TechanisYT/innoweek_amp/Neuer Ordner/2023-02-12 19_24_20-Negative voltage regulators - L7900_C.pdf – Mozilla Firefox.png

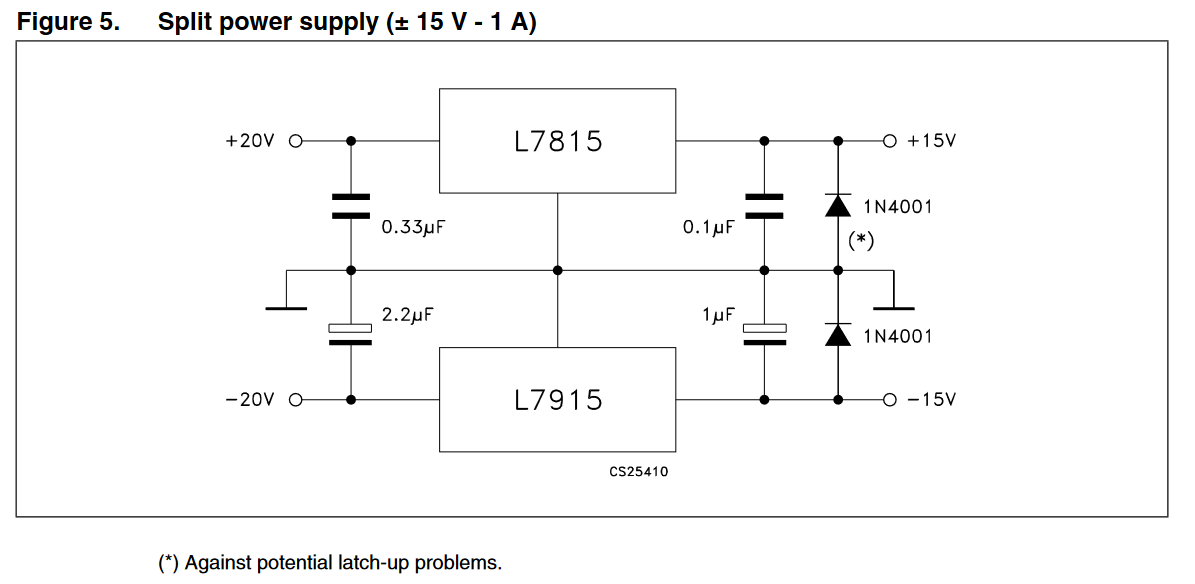
Neuer Ordner/2023-02-12 19_24_20-Negative voltage regulators - L7900_C.pdf – Mozilla Firefox.png
