TechanisYT/innoweek_amp/Steuerungs-Modul/v3.0/PCB.png

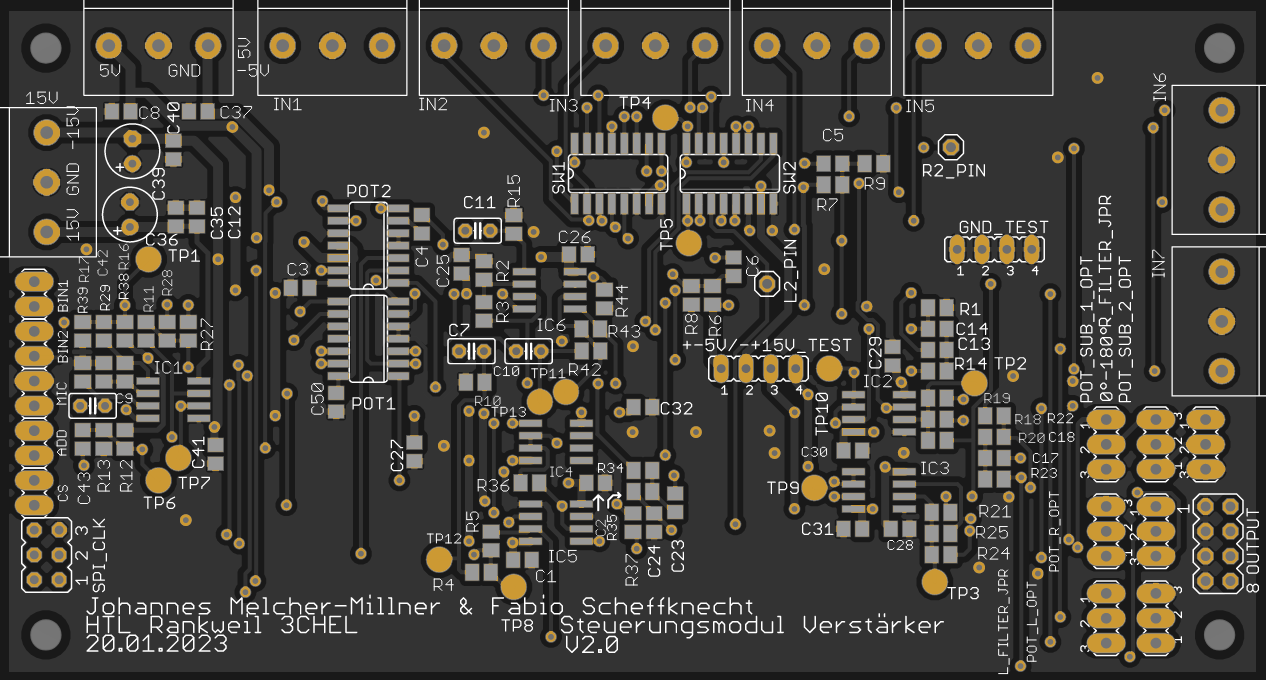
Steuerungs-Modul/v3.0/PCB.png
