TechanisYT/innoweek_amp/Steuerungs-Modul/v3.0/Steuerungsmodul.pdf

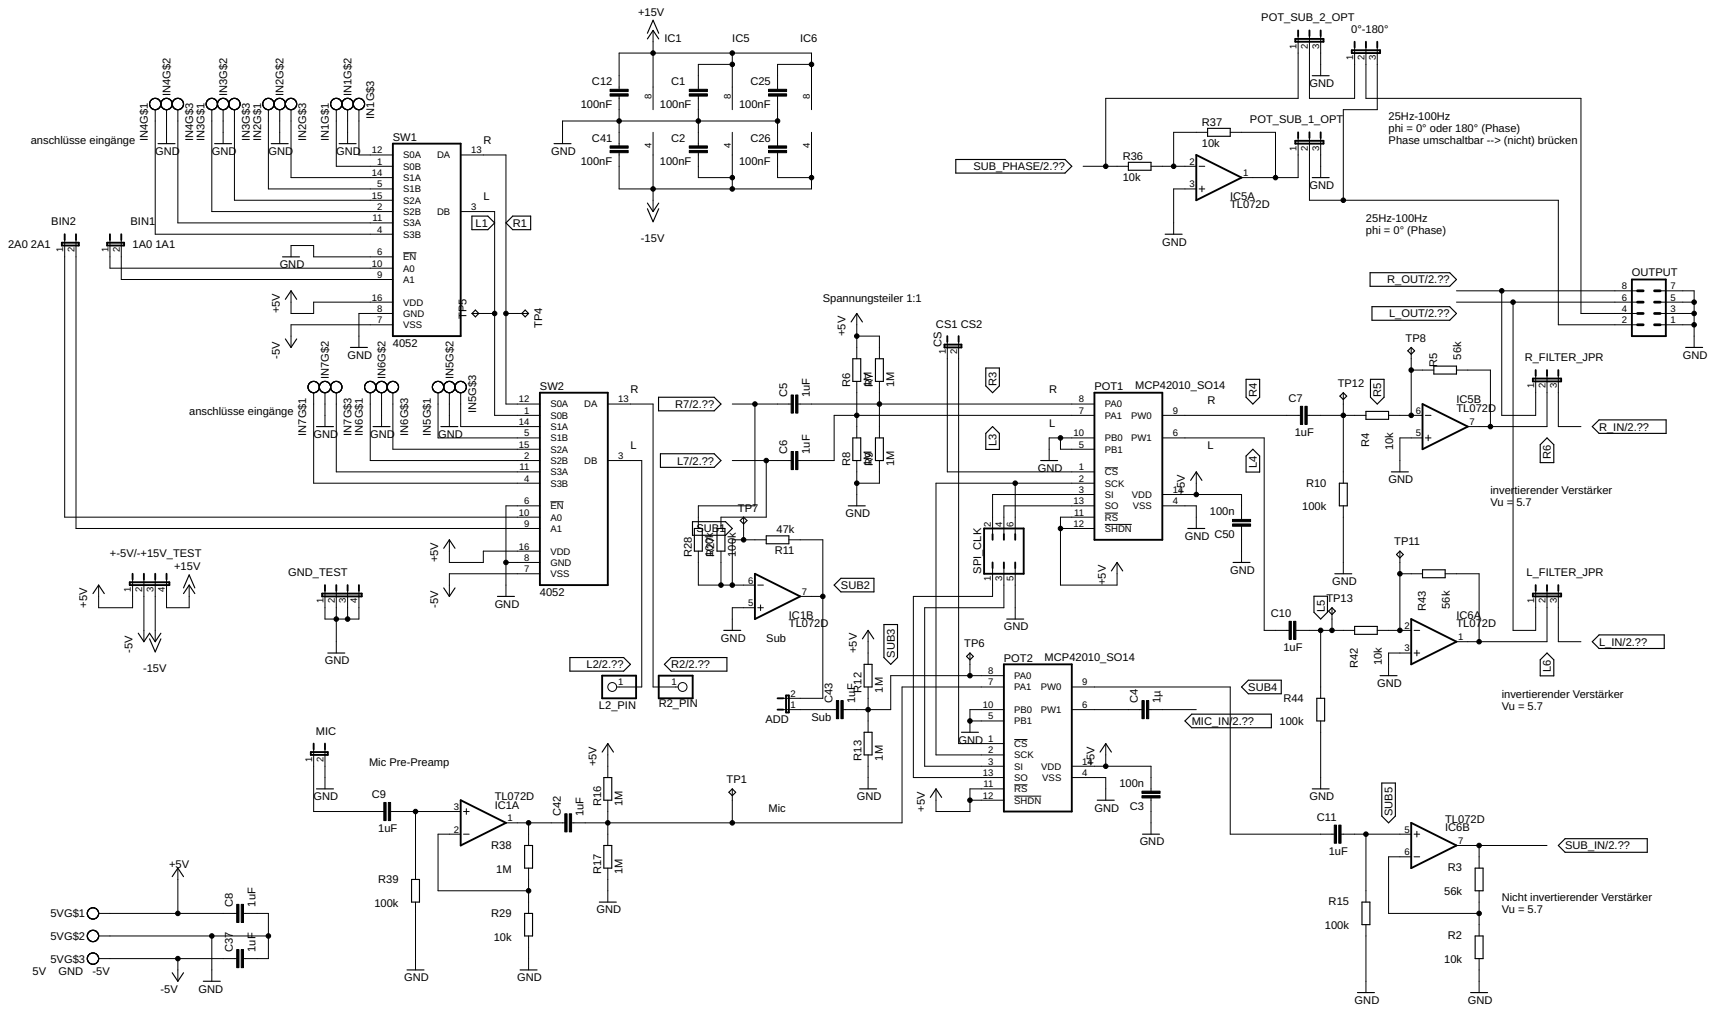
[picture p3: page 1]

25Hz-100Hz phi = 0° oder 180° (Phase)
Phase umschaltbar --> (nicht) brücken

Nicht invertierender Verstärker Vu = 5.7

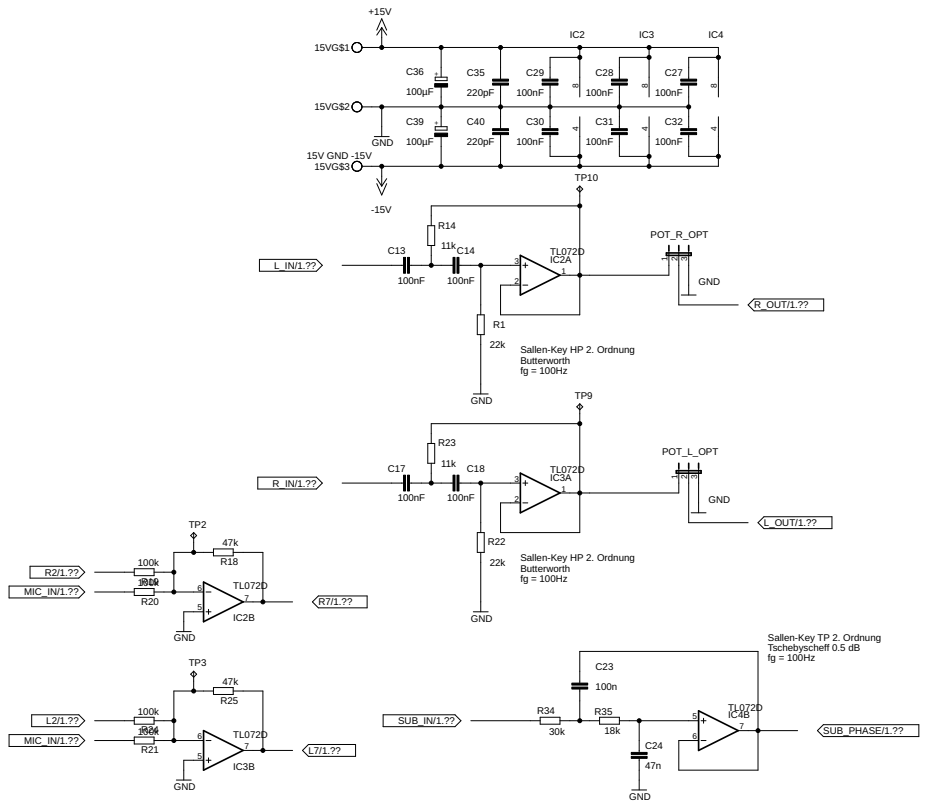
[picture p4: page 2]
