TechanisYT/innoweek_amp/Mono-Modul/Mono_Audio_Amplifier_Scheffknecht_Melcher.brd

## EAGLE design Mono-Modul/Mono_Audio_Amplifier_Scheffknecht_Melcher.brd (2023-11-27)

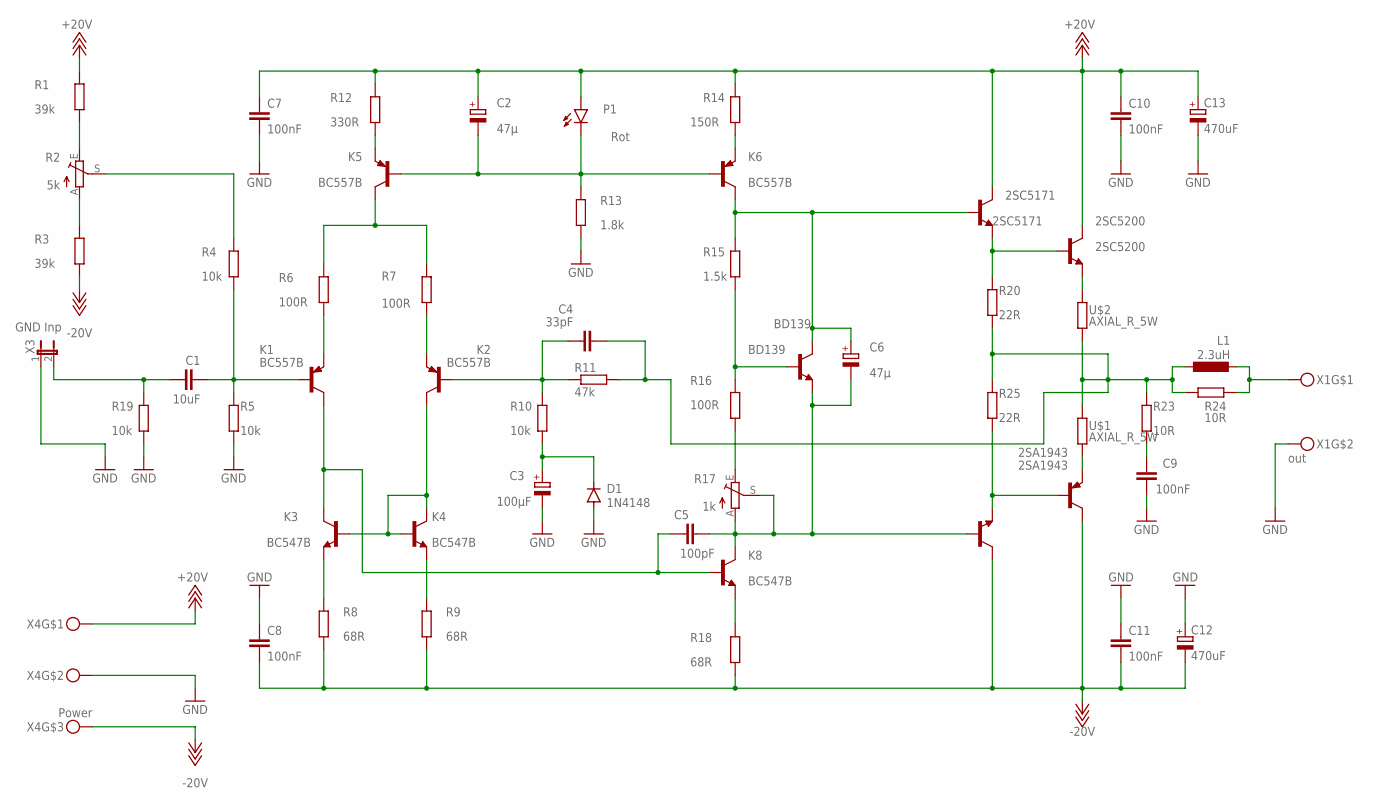
[picture p5: schematic Mono_Audio_Amplifier_Scheffknecht_Melcher.sch]

Parts:
2SA1930: 2SA1930; TO220BV
2SA1943: 2SA1943; TO264
2SC5171: 2SC5171; TO220BV
2SC5200: 2SC5200; TO264
BD139: BD139; TO126V
C1: 10uF; C0805
C2, C6: 47µ; E2,5-6
C3: 100µF; E2,5-7
C4: 33pF; C0805
C5: 100pF; C0805
C7, C8, C9, C10, C11: 100nF; C0805
C12, C13: 470uF; E3,5-8
D1: 1N4148; DO35-7
K1, K2, K5, K6: BC557B; TO92-EBC
K3, K4, K8: BC547B; TO92-CBE
L1: 2.3uH; TJ3-U2
P1: Rot; LED5MM
R1, R3: 39k; R0805
R2: 5k; S64W
R4, R5, R10, R19: 10k; R0805
R6, R7, R16: 100R; R0805
R8, R9, R18: 68R; R0805
R11: 47k; R0805
R12: 330R; R0805
R13: 1.8k; R0805
R14: 150R; R0805
R15: 1.5k; R0805
R17: 1k; S64W
R20, R25: 22R; R0805
R23, R24: 10R; R0805
U$1, U$2: AXIAL_R_5W; AXIAL_RESISTOR
X1: out; MKDS3/2_5,08
X3: GND Inp; JMP2
X4: Power; MKDS3/3_5,08

Connections:
+18V: 2SC5171.2 (C), 2SC5200.2 (C), C2.+, C7.1, C10.1, C13.+, P1.A, R1.1, R12.1, R14.1, X4.P$1
-18V: 2SA1930.2 (C), 2SA1943.2 (C), C8.2, C11.2, C12.-, R3.2, R8.2, R9.2, R18.2, X4.P$3
AUX_IN: C1.2, K1.B, R4.2, R5.1
GND: C3.-, C7.2, C8.1, C9.1, C10.2, C11.1, C12.+, C13.-, D1.A, R5.2, R13.2, R19.2, X1.P$2, X3.1, X4.P$2
unnamed: 2SC5200.3 (E), U$2.P$2 (2)
unnamed: 2SC5171.3 (E), 2SC5200.1 (B), R20.2
unnamed: 2SA1943.3 (E), U$1.P$1 (1)
unnamed: C4.2, L1.1, R11.2, R20.1, R23.2, R24.2, R25.2, U$1.P$2 (2), U$2.P$1 (1)
unnamed: C5.1, K1.C, K3.C, K8.B
unnamed: R16.2, R17.E
unnamed: BD139.3 (B), R15.2, R16.1
unnamed: 2SA1930.1 (B), BD139.1 (E), C5.2, C6.-, K8.C, R17.A, R17.S
unnamed: 2SC5171.1 (B), BD139.2 (C), C6.+, K6.C, R15.1
unnamed: K8.E, R18.1
unnamed: K6.E, R14.2
unnamed: K5.C, R6.1, R7.1
unnamed: K5.E, R12.2
unnamed: C4.1, K2.B, R10.1, R11.1
unnamed: K4.E, R9.1
unnamed: C2.-, K5.B, K6.B, P1.K (C), R13.1
unnamed: K1.E, R6.2
unnamed: K3.E, R8.1
unnamed: K2.E, R7.2
unnamed: K2.C, K3.B, K4.B, K4.C
unnamed: C3.+, D1.C, R10.2
unnamed: C9.2, R23.1
unnamed: C1.1, R19.1, X3.2
unnamed: R1.2, R2.E
unnamed: 2SA1930.3 (E), 2SA1943.1 (B), R25.1
unnamed: R2.S, R4.1
unnamed: R2.A, R3.1
unnamed: L1.2, R24.1, X1.P$1

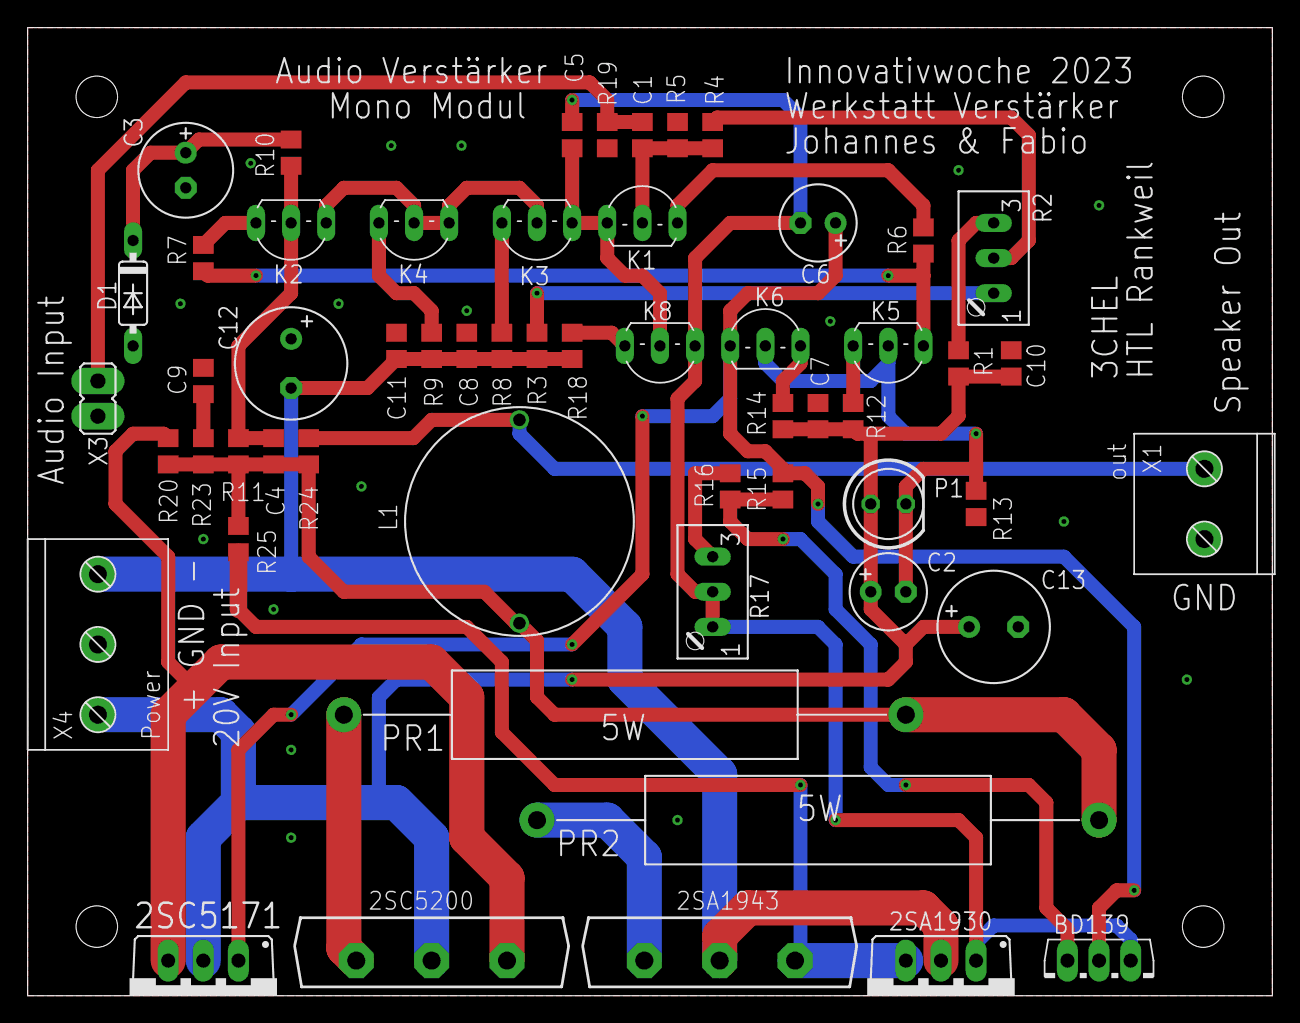
[picture p6: board Mono_Audio_Amplifier_Scheffknecht_Melcher.brd from above]

Board: 2 copper layers, 90.0 x 70.0 mm, 56 parts (0 on the bottom side), 32 nets.
