TechanisYT/innoweek_amp/Schul-Laptop/Scheffknecht_input_switch.brd

## EAGLE design Schul-Laptop/Scheffknecht_input_switch.brd (2023-11-27)

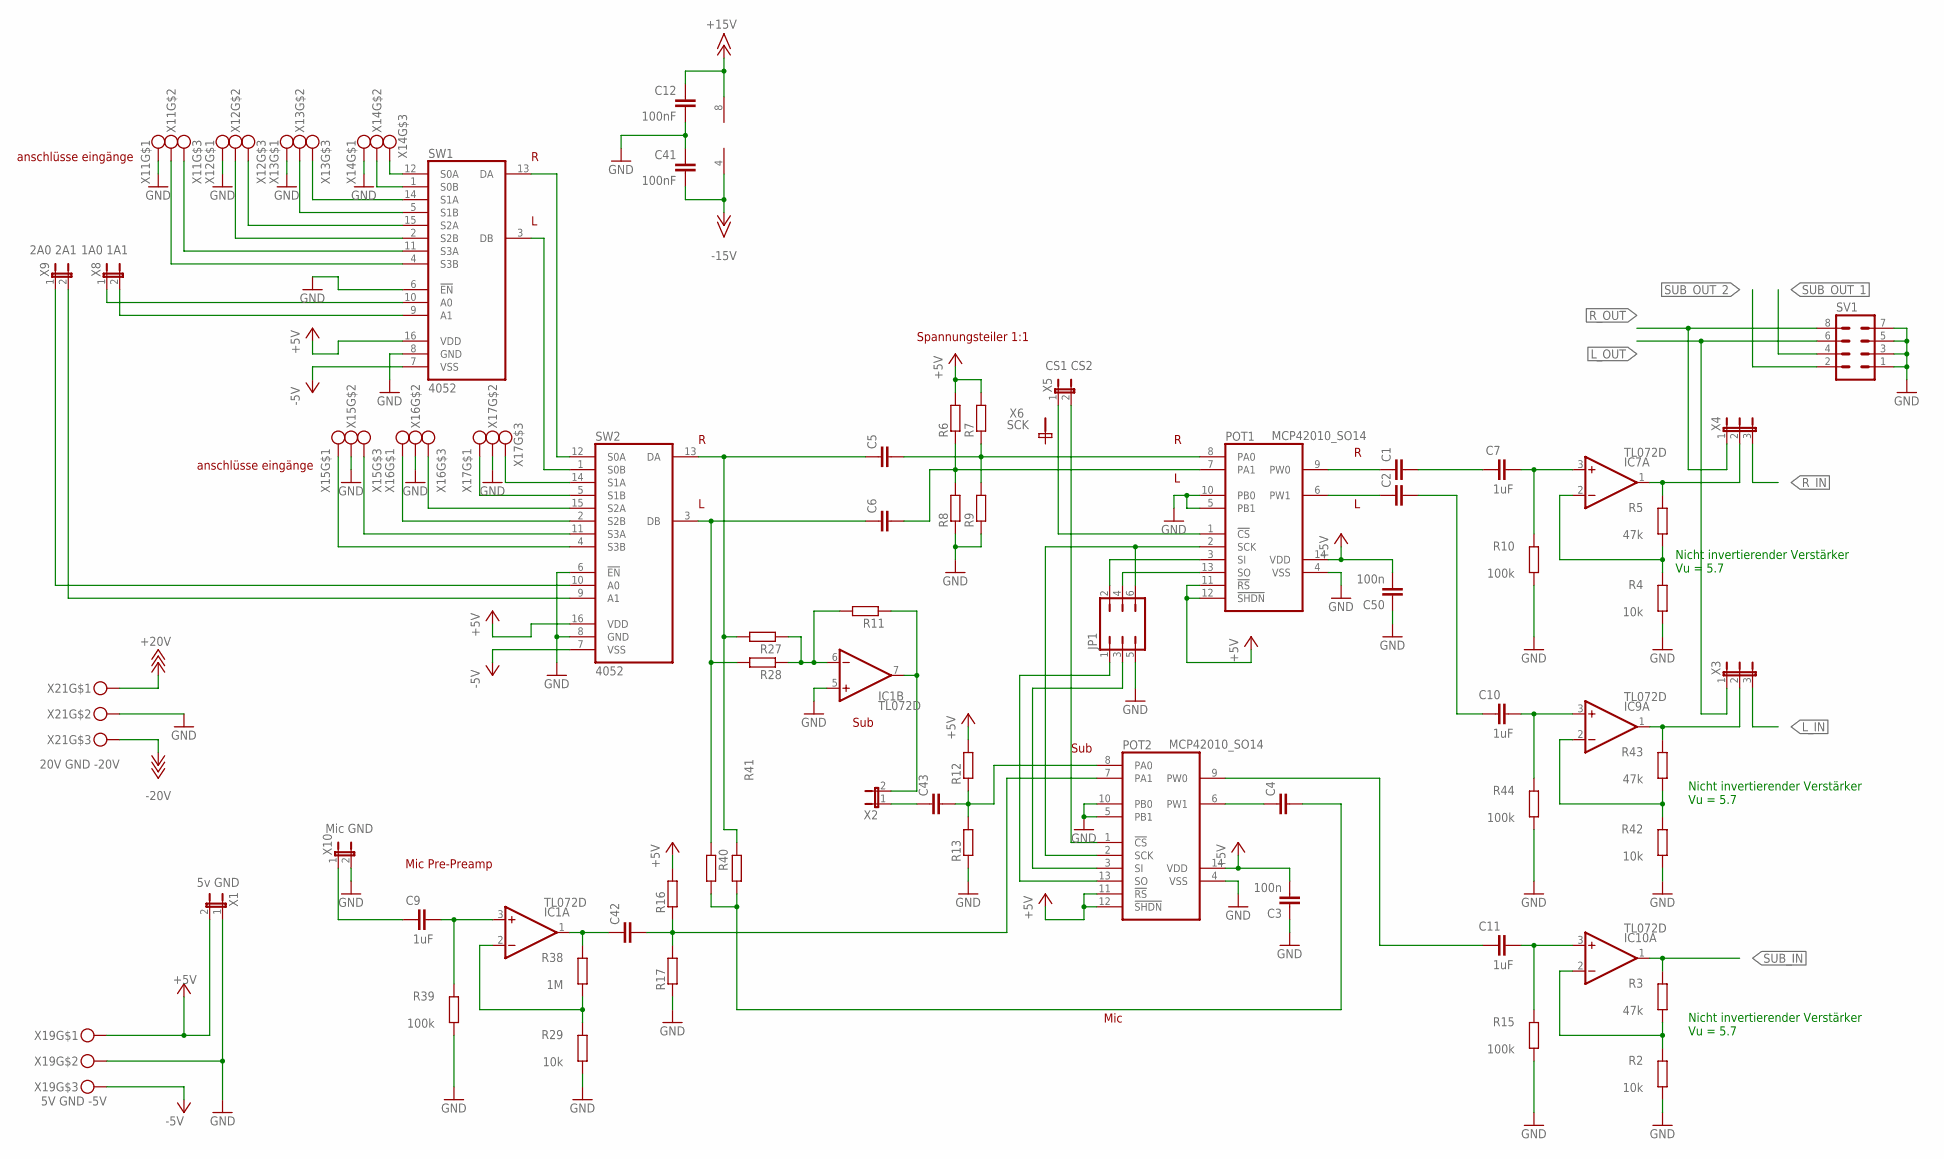
[picture p7: schematic Scheffknecht_input_switch.sch, sheet 1, Input Switch]

Parts:
C1, C2, C4, C5, C6, C42, C43: C-EUC0805; C0805
C3, C50: 100n; C0805
C7, C9, C10, C11: 1uF; C025-025X050
C12, C41: 100nF; C0805
FRAME1: HTL-A3-H; HTL-LEER
IC1, IC7, IC9, IC10: TL072D; SO08
JP1: JP3Q
POT1, POT2: MCP42010_SO14; SO14
R2, R4, R29, R42: 10k; M0805
R3, R5, R43: 47k; M0805
R6, R7, R8, R9, R11, R12, R13, R16, R17, R27, R28, R40, R41: R-EU_M0805; M0805
R10, R15, R39, R44: 100k; M0805
R38: 1M; M0805
SV1: MA04-2
SW1, SW2: 4052; SO-16
X1: 5v GND; JMP2
X2: JMP2
X3, X4: JMP3
X5: CS1 CS2; JMP2
X6: SCK; PIN1
X8: 1A0 1A1; JMP2
X9: 2A0 2A1; JMP2
X10: Mic GND; JMP2
X11, X12, X13, X14, X15, X16, X17: MKDS3/3_5,08
X19: 5V GND -5V; MKDS3/3_5,08
X21: 20V GND -20V; MKDS3/3_5,08

Connections:
+5V: C3.2, C50.2, POT1.11 (!RS), POT1.12 (!SHDN), POT1.14 (VDD), POT2.11 (!RS), POT2.12 (!SHDN), POT2.14 (VDD), R6.2, R7.2, R12.2, R16.2, SW1.16 (VDD), SW2.16 (VDD), X1.2, X19.P$1; also elsewhere on the board
+15V: C12.1, IC1.8 (V+); also elsewhere on the board
+18V: X21.P$1; also elsewhere on the board
-5V: SW1.7 (VSS), SW2.7 (VSS), X19.P$3; also elsewhere on the board
-15V: C41.2, IC1.4 (V-); also elsewhere on the board
-18V: X21.P$3; also elsewhere on the board
GND: C3.1, C12.2, C41.1, C50.1, IC1.5 (+IN), JP1.5, POT1.4 (VSS), POT1.5 (PB1), POT1.10 (PB0), POT2.4 (VSS), POT2.5 (PB1), POT2.10 (PB0), R2.1, R4.1, R8.1, R9.1, R10.1, R13.1, R15.1, R17.1, R29.1, R39.1, R42.1, R44.1, SV1.1, SV1.3, SV1.5, SV1.7, SW1.6 (!EN), SW1.8 (GND), SW2.6 (!EN), SW2.8 (GND), X1.1, X10.2, X11.P$1, X12.P$1, X13.P$1, X14.P$1, X15.P$2, X16.P$2, X17.P$2, X19.P$2, X21.P$2; also elsewhere on the board
L_IN: X3.3; also elsewhere on the board
L_OUT: SV1.6, X3.1; also elsewhere on the board
unnamed: POT2.1 (!CS), X5.2
unnamed: POT1.1 (!CS), X5.1
unnamed: SW1.3 (DB), SW2.1 (S0B)
unnamed: SW1.13 (DA), SW2.12 (S0A)
unnamed: SW1.9 (A1), X8.2
unnamed: SW1.10 (A0), X8.1
unnamed: SW2.9 (A1), X9.2
unnamed: SW2.10 (A0), X9.1
unnamed: C5.2, POT1.8 (PA0), R7.1, R9.2
unnamed: JP1.2, POT1.3 (SI)
unnamed: C7.2, IC7.3 (+IN), R10.2
unnamed: C5.1, R27.2, R41.1, SW2.13 (DA)
unnamed: C6.1, R28.2, R40.1, SW2.3 (DB)
unnamed: C2.2, C10.1
unnamed: C10.2, IC9.3 (+IN), R44.2
unnamed: IC1.6 (-IN), R11.2, R27.1, R28.1
unnamed: IC9.2 (-IN), R42.2, R43.1
unnamed: C1.1, POT1.9 (PW0)
unnamed: C6.2, POT1.7 (PA1), R6.1, R8.2
unnamed: C11.1, POT2.9 (PW0)
unnamed: C1.2, C7.1
unnamed: C11.2, IC10.3 (+IN), R15.2
unnamed: IC10.2 (-IN), R2.2, R3.1
unnamed: JP1.1, POT2.13 (SO)
unnamed: C2.1, POT1.6 (PW1)
unnamed: IC7.2 (-IN), R4.2, R5.1
unnamed: C43.2, POT2.8 (PA0), R12.1, R13.2
unnamed: C9.1, X10.1
unnamed: JP1.4, POT1.13 (SO)
unnamed: JP1.3, POT2.3 (SI)
unnamed: C4.1, POT2.6 (PW1)
unnamed: IC1.7 (OUT), R11.1, X2.2
unnamed: C42.2, POT2.7 (PA1), R16.1, R17.2
unnamed: JP1.6, POT1.2 (SCK), POT2.2 (SCK)
unnamed: SW1.12 (S0A), X14.P$3
unnamed: SW1.1 (S0B), X14.P$2
unnamed: SW1.14 (S1A), X13.P$3
unnamed: SW1.5 (S1B), X13.P$2
unnamed: SW1.15 (S2A), X12.P$3
unnamed: SW1.2 (S2B), X12.P$2
unnamed: SW1.11 (S3A), X11.P$3
unnamed: SW1.4 (S3B), X11.P$2
unnamed: SW2.14 (S1A), X17.P$3
unnamed: SW2.5 (S1B), X17.P$1
unnamed: SW2.15 (S2A), X16.P$3
unnamed: SW2.2 (S2B), X16.P$1
unnamed: SW2.11 (S3A), X15.P$3
unnamed: SW2.4 (S3B), X15.P$1
unnamed: C9.2, IC1.3 (+IN), R39.2
unnamed: IC9.1 (OUT), R43.2, X3.2
unnamed: IC7.1 (OUT), R5.2, X4.2
unnamed: IC1.2 (-IN), R29.2, R38.1
unnamed: C43.1, X2.1
unnamed: C42.1, IC1.1 (OUT), R38.2
unnamed: C4.2, R40.2, R41.2
R_IN: X4.3; also elsewhere on the board
R_OUT: SV1.8, X4.1; also elsewhere on the board
SUB_IN: IC10.1 (OUT), R3.2; also elsewhere on the board
SUB_OUT_1: SV1.4; also elsewhere on the board
SUB_OUT_2: SV1.2; also elsewhere on the board
V+: IC7.8 (V+), IC9.8 (V+), IC10.8 (V+)
V-: IC7.4 (V-), IC9.4 (V-), IC10.4 (V-)

Notes on the sheet:
Spannungsteiler 1:1
Sub
anschlüsse eingänge
Mic Pre-Preamp
Mic
Nicht invertierender Verstärker Vu = 5.7

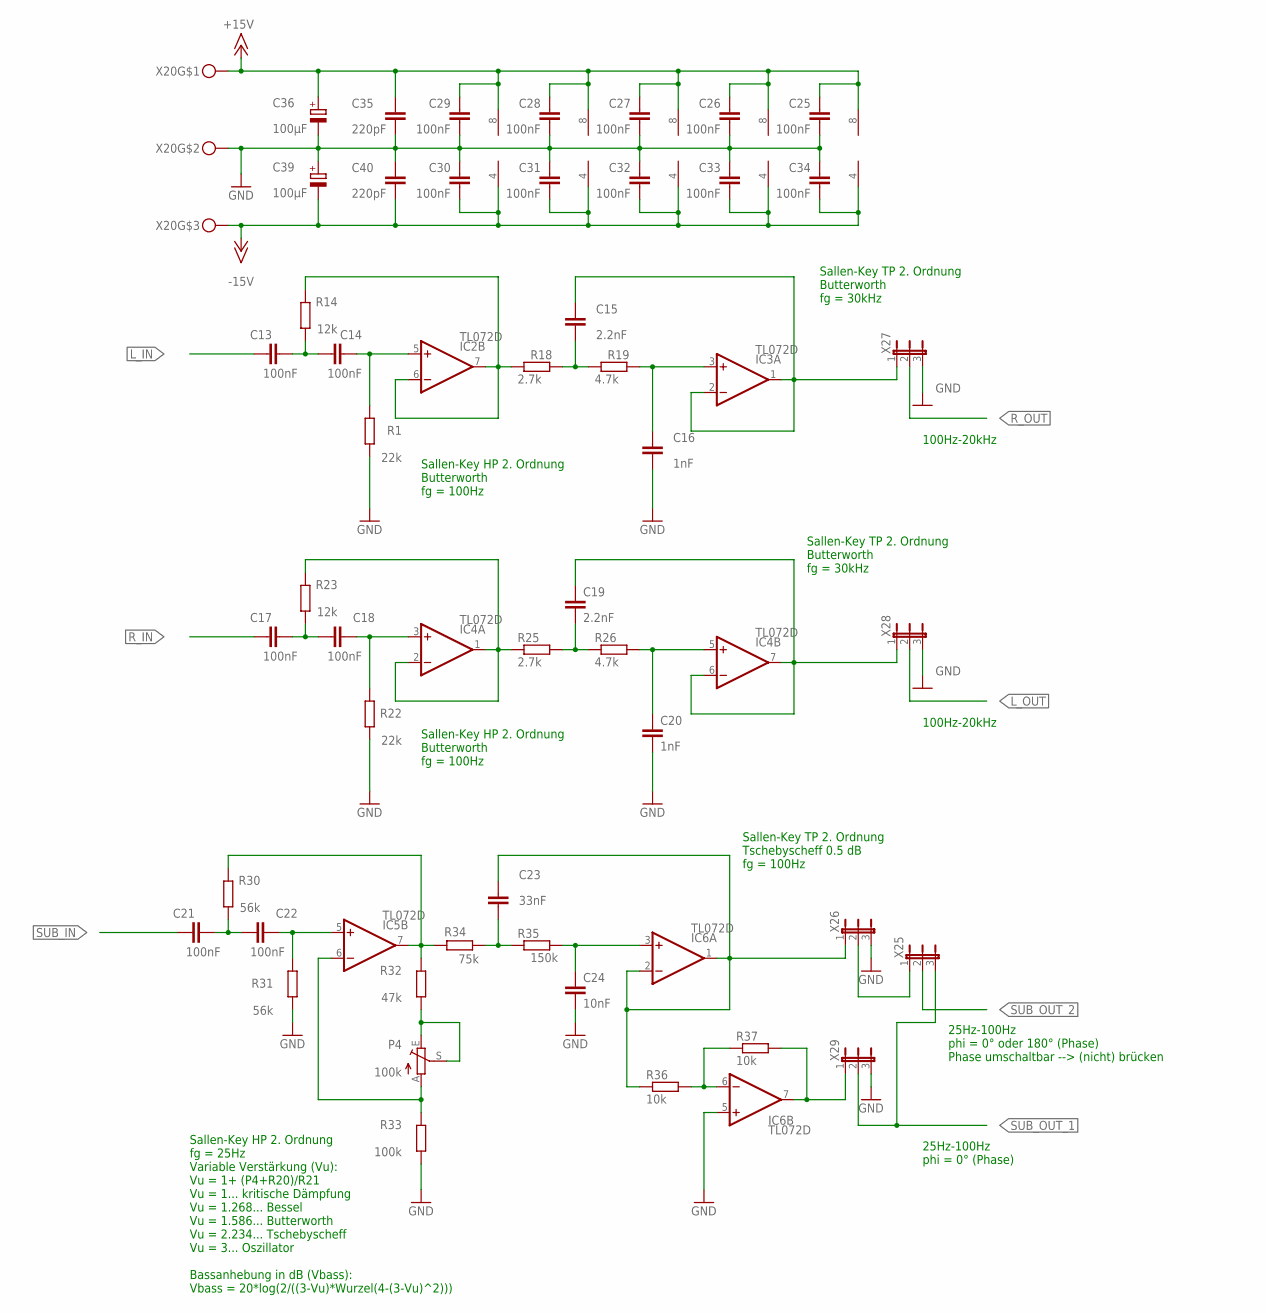
[picture p8: schematic Scheffknecht_input_switch.sch, sheet 2, Aktivfilter]

Parts:
C13, C14, C17, C18, C21, C22, C25, C26, C27, C28, C29, C30, C31, C32, C33, C34: 100nF; C0805
C15, C19: 2.2nF; C0805
C16, C20: 1nF; C0805
C23: 33nF; C0805
C24: 10nF; C0805
C35, C40: 220pF; C0805
C36, C39: 100µF; E2,5-6
FRAME2: HTL-A3-H; HTL-LEER
IC2, IC3, IC4, IC5, IC6: TL072D; SO08
P4: 100k; S64W
R1, R22: 22k; M0805
R14, R23: 12k; M0805
R18, R25: 2.7k; M0805
R19, R26: 4.7k; M0805
R30, R31: 56k; M0805
R32: 47k; M0805
R33: 100k; M0805
R34: 75k; M0805
R35: 150k; M0805
R36, R37: 10k; M0805
X20: MKDS3/3_5,08
X25, X26, X27, X28, X29: JMP3

Connections:
+15V: C25.1, C26.1, C27.1, C28.1, C29.1, C35.1, C36.+, IC2.8 (V+), IC3.8 (V+), IC4.8 (V+), IC5.8 (V+), IC6.8 (V+), X20.P$1; also elsewhere on the board
-15V: C30.2, C31.2, C32.2, C33.2, C34.2, C39.-, C40.2, IC2.4 (V-), IC3.4 (V-), IC4.4 (V-), IC5.4 (V-), IC6.4 (V-), X20.P$3; also elsewhere on the board
GND: C16.2, C20.2, C24.2, IC6.5 (+IN), R1.1, R22.1, R31.1, R33.1, X26.3, X27.3, X28.3, X29.3; also elsewhere on the board
GND1: C25.2, C26.2, C27.2, C28.2, C29.2, C30.1, C31.1, C32.1, C33.1, C34.1, C35.2, C36.-, C39.+, C40.1, X20.P$2
L_IN: C13.1; also elsewhere on the board
L_OUT: X28.2; also elsewhere on the board
unnamed: IC2.6 (-IN), IC2.7 (OUT), R14.2, R18.1
unnamed: C14.2, IC2.5 (+IN), R1.2
unnamed: C13.2, C14.1, R14.1
unnamed: C15.2, R18.2, R19.1
unnamed: C16.1, IC3.3 (+IN), R19.2
unnamed: C15.1, IC3.1 (OUT), IC3.2 (-IN), X27.1
unnamed: IC4.1 (OUT), IC4.2 (-IN), R23.2, R25.1
unnamed: C18.2, IC4.3 (+IN), R22.2
unnamed: C17.2, C18.1, R23.1
unnamed: C19.2, R25.2, R26.1
unnamed: C20.1, IC4.5 (+IN), R26.2
unnamed: C19.1, IC4.6 (-IN), IC4.7 (OUT)
unnamed: C21.2, C22.1, R30.1
unnamed: C22.2, IC5.5 (+IN), R31.2
unnamed: IC5.7 (OUT), R30.2, R32.2, R34.2
unnamed: IC5.6 (-IN), P4.A, R33.2
unnamed: P4.E, P4.S, R32.1
unnamed: C24.1, IC6.3 (+IN), R35.2
unnamed: C23.2, R34.1, R35.1
unnamed: IC6.6 (-IN), R36.2, R37.1
unnamed: X25.1, X26.2
R_IN: C17.1; also elsewhere on the board
R_OUT: X27.2; also elsewhere on the board
SUB_IN: C21.1; also elsewhere on the board
SUB_OUT: IC6.7 (OUT), R37.2, X29.1
SUB_OUT-180: C23.1, IC6.1 (OUT), IC6.2 (-IN), R36.1, X26.1
SUB_OUT_1: X25.3, X29.2; also elsewhere on the board
SUB_OUT_2: X25.2; also elsewhere on the board

Notes on the sheet:
100Hz-20kHz
25Hz-100Hz phi = 0° oder 180° (Phase) Phase umschaltbar --> (nicht) brücken
25Hz-100Hz phi = 0° (Phase)
Sallen-Key TP 2. Ordnung Butterworth fg = 30kHz
Sallen-Key HP 2. Ordnung Butterworth fg = 100Hz
Sallen-Key TP 2. Ordnung Tschebyscheff 0.5 dB fg = 100Hz
Sallen-Key HP 2. Ordnung fg = 25Hz Variable Verstärkung (Vu): Vu = 1+ (P4+R20)/R21 Vu = 1... kritische Dämpfung Vu = 1.268... Bessel Vu = 1.586... Butterworth Vu = 2.234... Tschebyscheff Vu = 3... Oszillator Bassanhebung in dB (Vbass): Vbass = 20*log(2/((3-Vu)*Wurzel(4-(3-Vu)^2)))

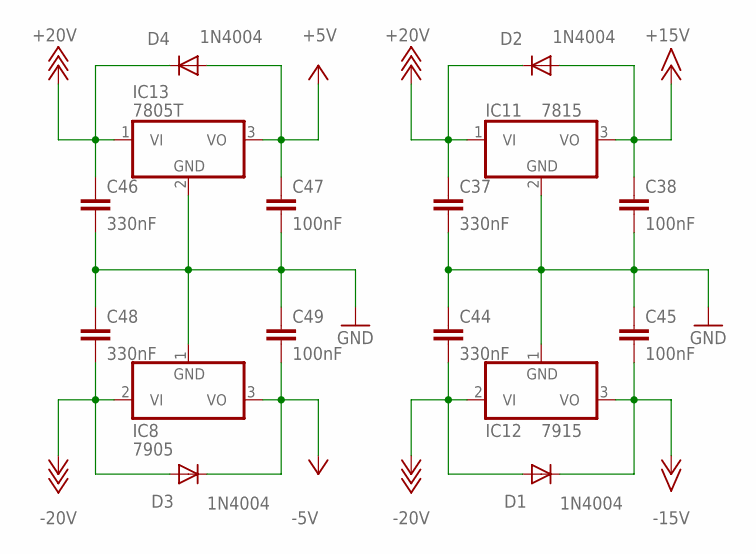
[picture p9: schematic Scheffknecht_input_switch.sch, sheet 3, Spannungsregler]

Parts:
C37, C44, C46, C48: 330nF; C0805
C38, C45, C47, C49: 100nF; C0805
D1, D2, D3, D4: 1N4004; DO41-10
FRAME3: HTL-A4-H; HTL-LEER
IC8: 7905; TO220H
IC11: 7815; TO220H
IC12: 7915; TO220H
IC13: 7805T; TO220H

Connections:
+5V: C47.1, D4.A, IC13.3 (VO); also elsewhere on the board
+15V: C38.1, D2.A, IC11.3 (VO); also elsewhere on the board
+18V: C37.1, C46.1, D2.C, D4.C, IC11.1 (VI), IC13.1 (VI); also elsewhere on the board
-5V: C49.2, D3.C, IC8.3 (VO); also elsewhere on the board
-15V: C45.2, D1.C, IC12.3 (VO); also elsewhere on the board
-18V: C44.2, C48.2, D1.A, D3.A, IC8.2 (VI), IC12.2 (VI); also elsewhere on the board
GND: C37.2, C38.2, C44.1, C45.1, C46.2, C47.2, C48.1, C49.1, IC8.1 (GND), IC11.2 (GND), IC12.1 (GND), IC13.2 (GND); also elsewhere on the board

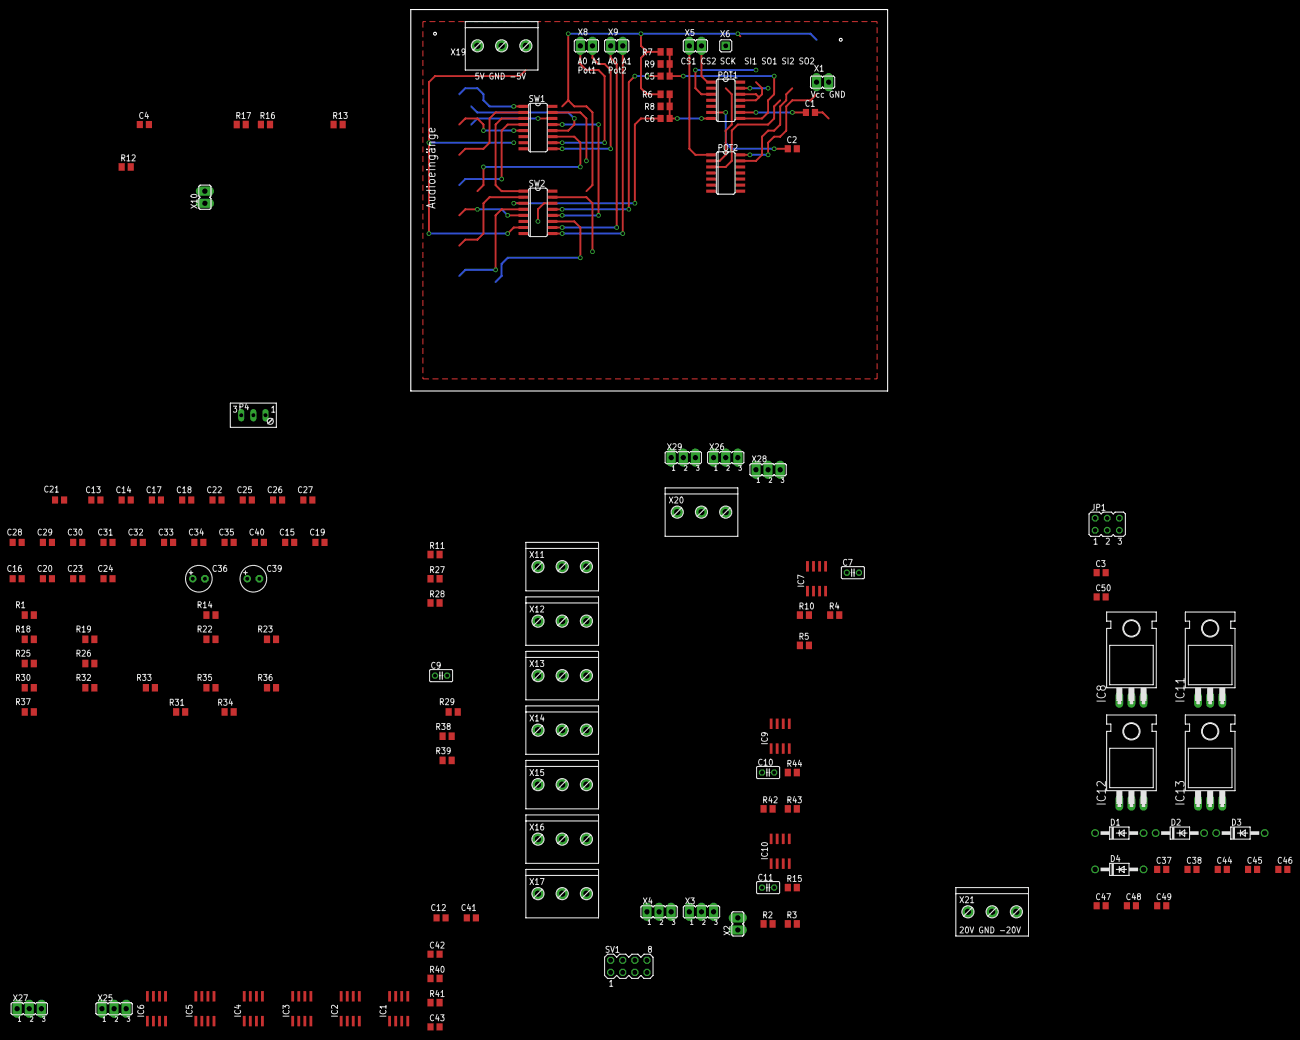
[picture p10: board Scheffknecht_input_switch.brd from above]

Board: 2 copper layers, 100.0 x 80.0 mm, 141 parts (0 on the bottom side), 95 nets.
