TechanisYT/innoweek_amp/Power-Supply/20V-Endstufen/Netzteil_Endstufe.brd

## EAGLE design Power-Supply/20V-Endstufen/Netzteil_Endstufe.brd (2023-11-27)

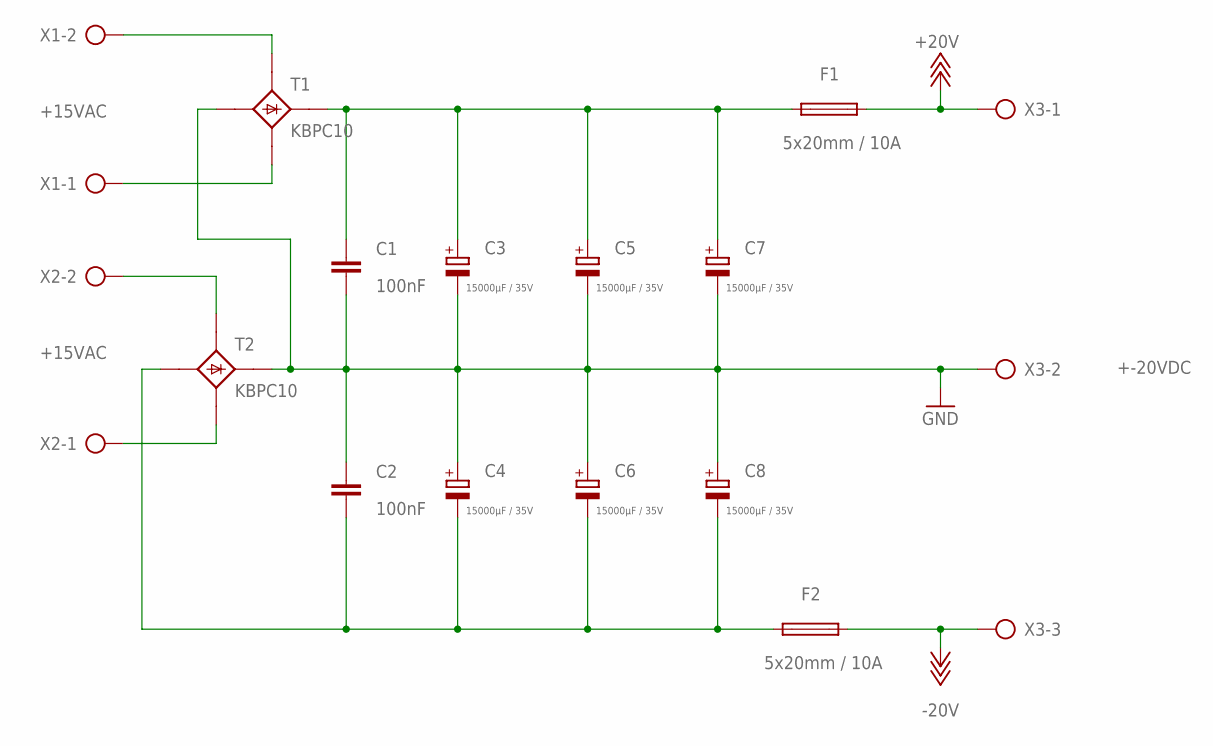
[picture p11: schematic Netzteil_Endstufe.sch]

Parts:
C1, C2: 100nF; C025-025X050
C3, C4, C5, C6, C7, C8: 15000µF / 35V; EB22,5D
F1, F2: 5x20mm / 10A; SHK20L
T1, T2: KBPC10; B25A-
X1, X2: +15VAC; AK300/2
X3: +-20VDC; AK300/3

Connections:
+18V: F1.2A (2), X3.1
-18V: F2.2A (2), X3.3
GND: C1.2, C2.1, C3.-, C4.+, C5.-, C6.+, C7.-, C8.+, T1.-1 (-), T2.+1 (+), X3.2
unnamed: T2.AC1- (AC1), X2.2
unnamed: C1.1, C3.+, C5.+, C7.+, F1.1A (1), T1.+1 (+)
unnamed: C2.2, C4.-, C6.-, C8.-, F2.1A (1), T2.-1 (-)
unnamed: T1.AC1- (AC1), X1.2
unnamed: T1.AC2- (AC2), X1.1
unnamed: T2.AC2- (AC2), X2.1

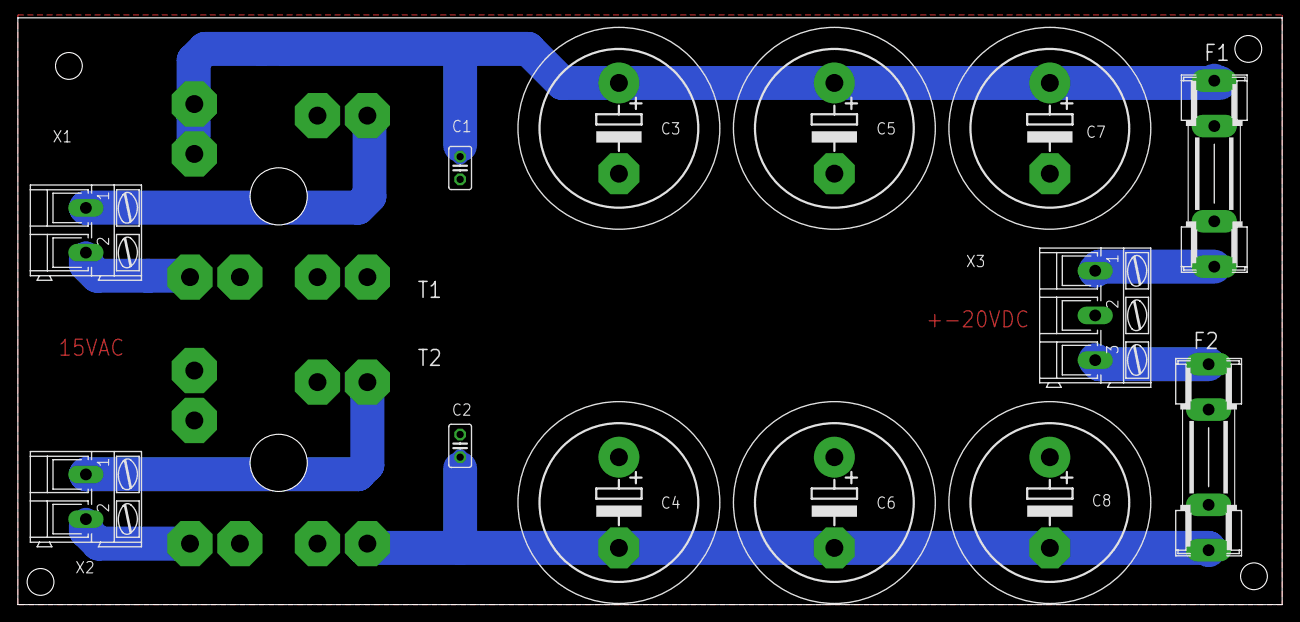
[picture p12: board Netzteil_Endstufe.brd from above]

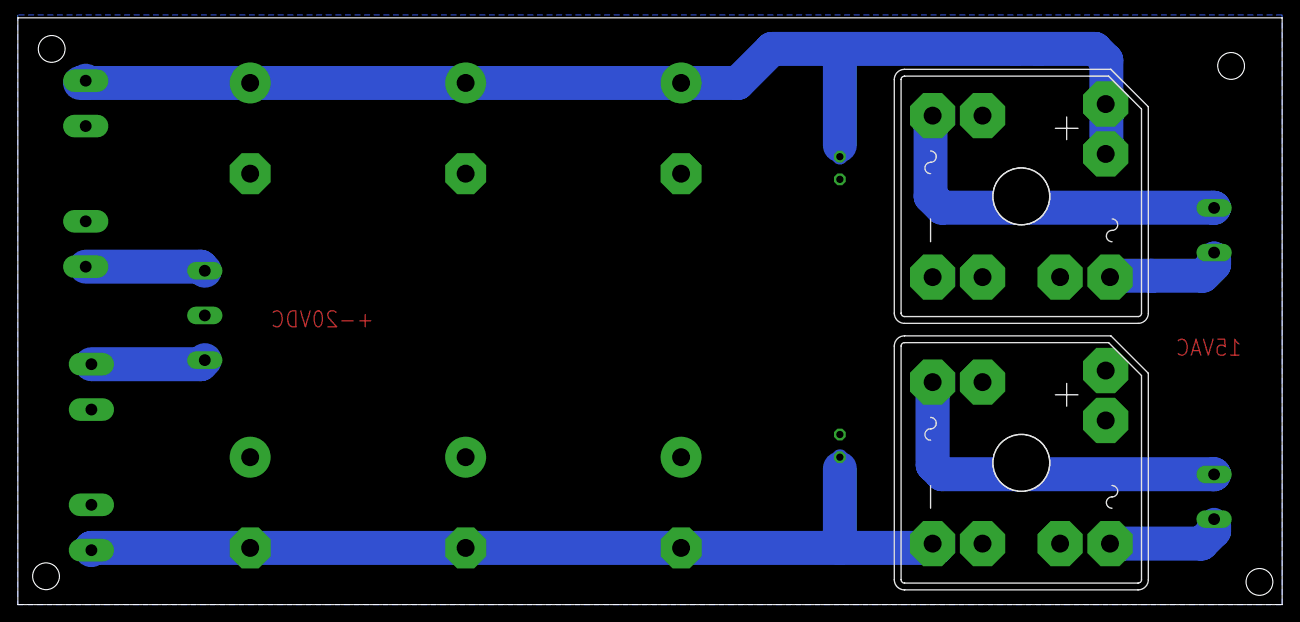
[picture p13: board Netzteil_Endstufe.brd from below]

Board: 2 copper layers, 141.6 x 65.7 mm, 15 parts (2 on the bottom side), 9 nets.
