TechanisYT/innoweek_amp/Power-Supply/15V-OPV/Netzteil_OPV.brd

## EAGLE design Power-Supply/15V-OPV/Netzteil_OPV.brd (2023-11-27)

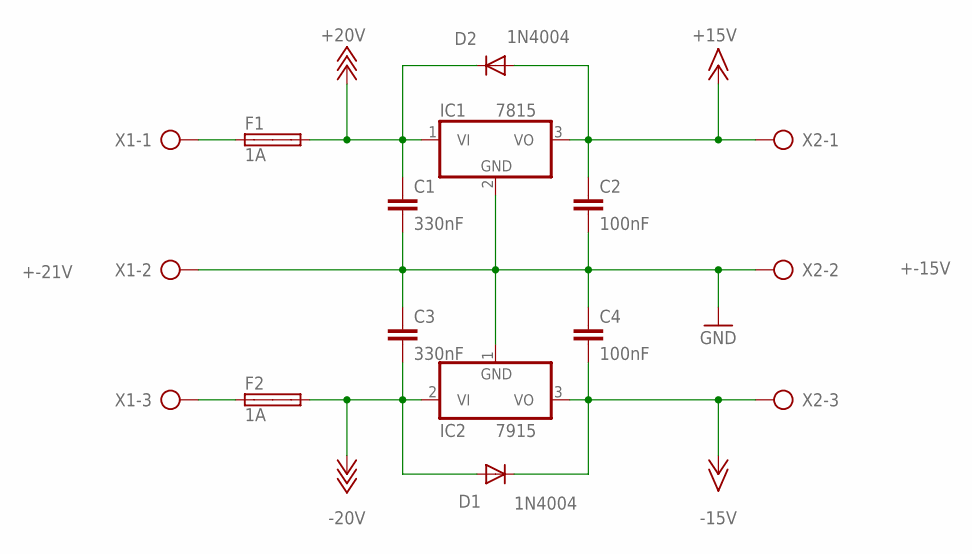
[picture p14: schematic Netzteil_OPV.sch]

Parts:
C1, C3: 330nF; C025-025X050
C2, C4: 100nF; C025-025X050
D1, D2: 1N4004; DO41-10
F1, F2: 1A; SHK20L
IC1: 7815; TO220H
IC2: 7915; TO220H
X1: +-21V; AK300/3
X2: +-15V; AK300/3

Connections:
+15V: C2.1, D2.A, IC1.3 (VO), X2.1
+18V: C1.1, D2.C, F1.2A, IC1.1 (VI)
-15V: C4.2, D1.C, IC2.3 (VO), X2.3
-18V: C3.2, D1.A, F2.2A, IC2.2 (VI)
GND: C1.2, C2.2, C3.1, C4.1, IC1.2 (GND), IC2.1 (GND), X1.2, X2.2
unnamed: F1.1A, X1.1
unnamed: F2.1A, X1.3

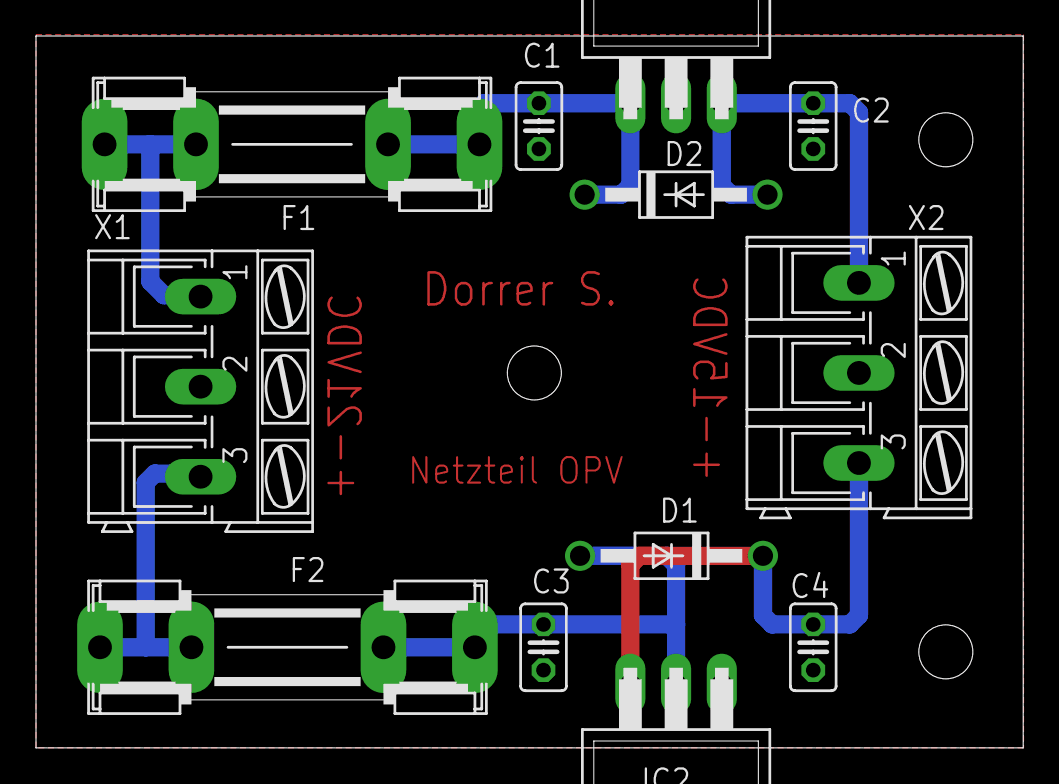
[picture p15: board Netzteil_OPV.brd from above]

Board: 2 copper layers, 54.8 x 39.5 mm, 12 parts (0 on the bottom side), 7 nets.
