TechanisYT/innoweek_amp/Steuerungs-Modul/v2.0/Steuerungsmodul.brd

## EAGLE design Steuerungs-Modul/v2.0/Steuerungsmodul.brd (2023-11-27, an earlier design)

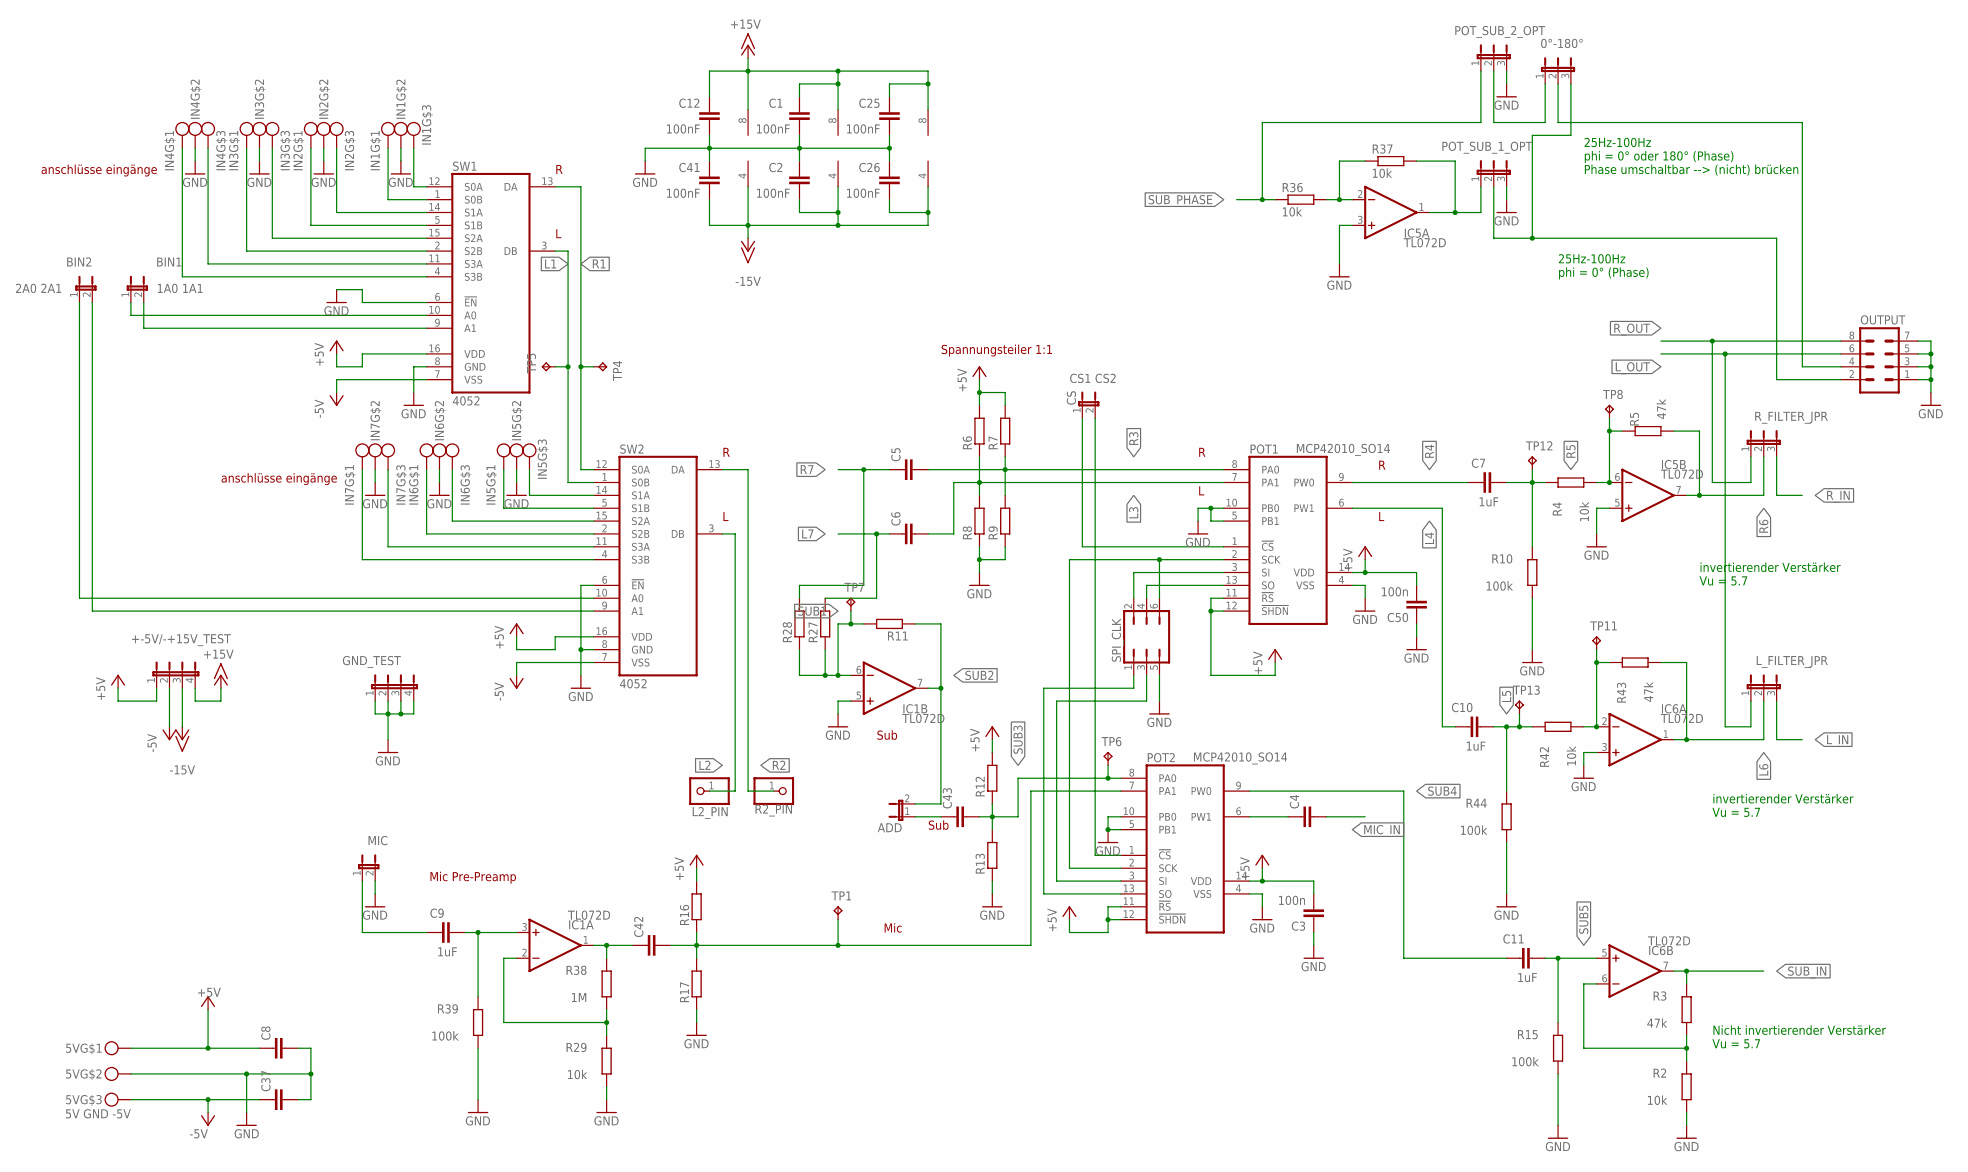
[picture p16: schematic Steuerungsmodul.sch, sheet 1, Input Switch]

Parts:
0°-180°: JMP3
5V: 5V GND -5V; MKDS3/3_5,08
+-5V/-+15V_TEST: JP4E; JP4
ADD: JMP2
BIN1: 1A0 1A1; JMP2
BIN2: 2A0 2A1; JMP2
C1, C2, C12, C25, C26, C41: 100nF; C0805
C3, C50: 100n; C0805
C4, C5, C6, C8, C37, C42, C43: C-EUC0805; C0805
C7, C9, C10, C11: 1uF; C025-025X050
CS: CS1 CS2; JMP2
GND_TEST: JP4E; JP4
IC1, IC5, IC6: TL072D; SO08
IN1, IN2, IN3, IN4, IN5, IN6, IN7: MKDS3/3_5,08
L2_PIN: PINHD-1X1; 1X01
L_FILTER_JPR: JMP3
MIC: JMP2
OUTPUT: MA04-2
POT1, POT2: MCP42010_SO14; SO14
POT_SUB_1_OPT, POT_SUB_2_OPT: JMP3
R2, R4, R29, R36, R37, R42: 10k; M0805
R2_PIN: PINHD-1X1; 1X01
R3, R5, R43: 47k; M0805
R6, R7, R8, R9, R11, R12, R13, R16, R17, R27, R28: R-EU_M0805; M0805
R10, R15, R39, R44: 100k; M0805
R38: 1M; M0805
R_FILTER_JPR: JMP3
SPI_CLK: JP3Q
SW1, SW2: 4052; SO-16
TP1, TP4, TP5, TP6, TP7, TP8, TP11, TP12, TP13: TPB2,54; B2,54

Connections:
1A0: BIN1.1, SW1.10 (A0)
1A1: BIN1.2, SW1.9 (A1)
2A0: BIN2.1, SW2.10 (A0)
2A1: BIN2.2, SW2.9 (A1)
+5V: 5V.P$1, +-5V/-+15V_TEST.1, C3.2, C8.1, C50.2, POT1.11 (!RS), POT1.12 (!SHDN), POT1.14 (VDD), POT2.11 (!RS), POT2.12 (!SHDN), POT2.14 (VDD), R6.2, R7.2, R12.2, R16.2, SW1.16 (VDD), SW2.16 (VDD)
+15V: +-5V/-+15V_TEST.4, C1.1, C12.1, C25.1, IC1.8 (V+), IC5.8 (V+), IC6.8 (V+); also elsewhere on the board
-5V: 5V.P$3, +-5V/-+15V_TEST.2, C37.1, SW1.7 (VSS), SW2.7 (VSS)
-15V: +-5V/-+15V_TEST.3, C2.2, C26.2, C41.2, IC1.4 (V-), IC5.4 (V-), IC6.4 (V-); also elsewhere on the board
GND: 5V.P$2, C1.2, C2.1, C3.1, C8.2, C12.2, C25.2, C26.1, C37.2, C41.1, C50.1, GND_TEST.1, GND_TEST.2, GND_TEST.3, GND_TEST.4, IC1.5 (+IN), IC5.3 (+IN), IC5.5 (+IN), IC6.3 (+IN), IN1.P$2, IN2.P$2, IN3.P$2, IN4.P$2, IN5.P$2, IN6.P$2, IN7.P$2, MIC.2, OUTPUT.1, OUTPUT.3, OUTPUT.5, OUTPUT.7, POT1.4 (VSS), POT1.5 (PB1), POT1.10 (PB0), POT2.4 (VSS), POT2.5 (PB1), POT2.10 (PB0), POT_SUB_1_OPT.3, POT_SUB_2_OPT.3, R2.1, R8.1, R9.1, R10.1, R13.1, R15.1, R17.1, R29.1, R39.1, R44.1, SPI_CLK.5, SW1.6 (!EN), SW1.8 (GND), SW2.6 (!EN), SW2.8 (GND); also elsewhere on the board
L1: SW1.3 (DB), SW2.1 (S0B), TP5.TP
L2: L2_PIN.1, SW2.3 (DB); also elsewhere on the board
L3: C6.2, POT1.7 (PA1), R6.1, R8.2
L4: C10.1, POT1.6 (PW1)
L5: C10.2, R42.2, R44.2, TP13.TP
L6: IC6.1 (OUT), L_FILTER_JPR.2, R43.1
L7: C6.1, R27.2; also elsewhere on the board
L_IN: L_FILTER_JPR.3; also elsewhere on the board
L_OUT: L_FILTER_JPR.1, OUTPUT.6; also elsewhere on the board
MIC_IN: C4.2; also elsewhere on the board
unnamed: CS.2, POT2.1 (!CS)
unnamed: CS.1, POT1.1 (!CS)
unnamed: IC5.1 (OUT), POT_SUB_1_OPT.1, R37.2
unnamed: IC5.6 (-IN), R4.1, R5.2, TP8.TP
unnamed: IC6.2 (-IN), R42.1, R43.2, TP11.TP
unnamed: POT1.3 (SI), SPI_CLK.2
unnamed: IC6.6 (-IN), R2.2, R3.1
unnamed: POT2.13 (SO), SPI_CLK.1
unnamed: C9.1, MIC.1
unnamed: POT1.13 (SO), SPI_CLK.4
unnamed: POT2.3 (SI), SPI_CLK.3
unnamed: C4.1, POT2.6 (PW1)
unnamed: C42.2, POT2.7 (PA1), R16.1, R17.2, TP1.TP
unnamed: POT1.2 (SCK), POT2.2 (SCK), SPI_CLK.6
unnamed: IN1.P$3, SW1.12 (S0A)
unnamed: IN1.P$1, SW1.1 (S0B)
unnamed: IN2.P$3, SW1.14 (S1A)
unnamed: IN2.P$1, SW1.5 (S1B)
unnamed: IN3.P$3, SW1.15 (S2A)
unnamed: IN3.P$1, SW1.2 (S2B)
unnamed: IN4.P$3, SW1.11 (S3A)
unnamed: IN4.P$1, SW1.4 (S3B)
unnamed: IN5.P$3, SW2.14 (S1A)
unnamed: IN5.P$1, SW2.5 (S1B)
unnamed: IN6.P$3, SW2.15 (S2A)
unnamed: IN6.P$1, SW2.2 (S2B)
unnamed: IN7.P$3, SW2.11 (S3A)
unnamed: IN7.P$1, SW2.4 (S3B)
unnamed: C9.2, IC1.3 (+IN), R39.2
unnamed: IC1.2 (-IN), R29.2, R38.1
unnamed: ADD.1, C43.1
unnamed: C42.1, IC1.1 (OUT), R38.2
unnamed: IC5.2 (-IN), R36.2, R37.1
unnamed: 0°-180°.1, POT_SUB_2_OPT.2
R1: SW1.13 (DA), SW2.12 (S0A), TP4.TP
R2: R2_PIN.1, SW2.13 (DA); also elsewhere on the board
R3: C5.2, POT1.8 (PA0), R7.1, R9.2
R4: C7.1, POT1.9 (PW0)
R5: C7.2, R4.2, R10.2, TP12.TP
R6: IC5.7 (OUT), R5.1, R_FILTER_JPR.2
R7: C5.1, R28.2; also elsewhere on the board
R_IN: R_FILTER_JPR.3; also elsewhere on the board
R_OUT: OUTPUT.8, R_FILTER_JPR.1; also elsewhere on the board
SUB1: IC1.6 (-IN), R11.2, R27.1, R28.1, TP7.TP
SUB2: ADD.2, IC1.7 (OUT), R11.1
SUB3: C43.2, POT2.8 (PA0), R12.1, R13.2, TP6.TP
SUB4: C11.1, POT2.9 (PW0)
SUB5: C11.2, IC6.5 (+IN), R15.2
SUB_IN: IC6.7 (OUT), R3.2; also elsewhere on the board
SUB_OUT_1: 0°-180°.3, OUTPUT.2, POT_SUB_1_OPT.2
SUB_OUT_2: 0°-180°.2, OUTPUT.4
SUB_PHASE: POT_SUB_2_OPT.1, R36.1; also elsewhere on the board

Notes on the sheet:
Spannungsteiler 1:1
Sub
anschlüsse eingänge
Mic Pre-Preamp
Mic
invertierender Verstärker Vu = 5.7
Nicht invertierender Verstärker Vu = 5.7
25Hz-100Hz phi = 0° oder 180° (Phase) Phase umschaltbar --> (nicht) brücken
25Hz-100Hz phi = 0° (Phase)

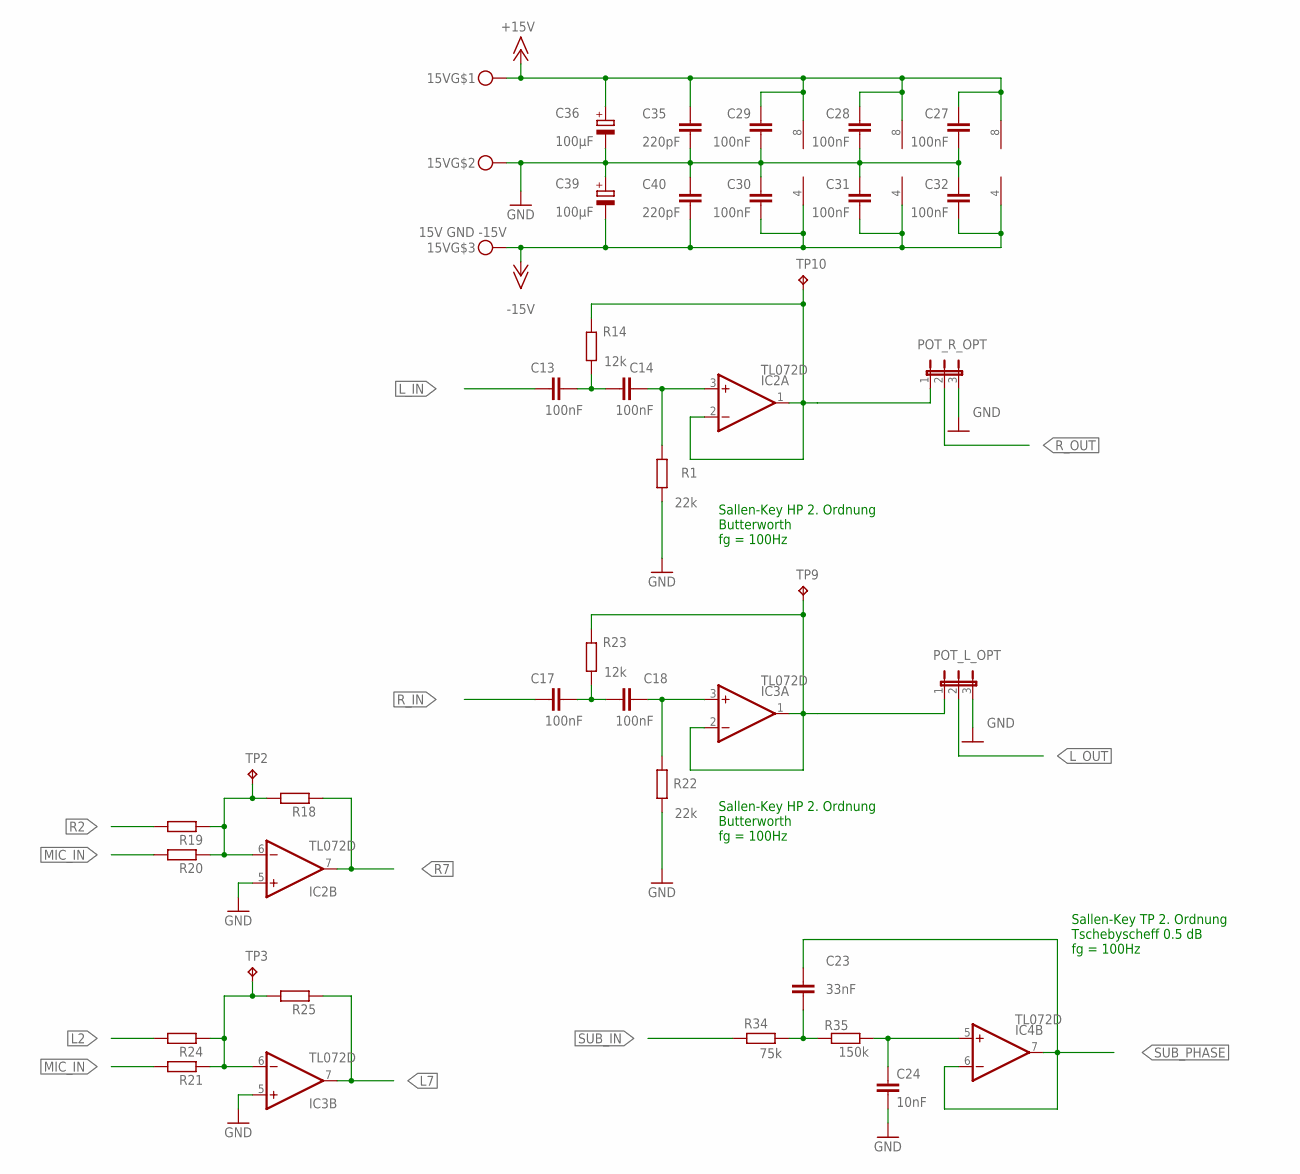
[picture p17: schematic Steuerungsmodul.sch, sheet 2, Aktivfilter]

Parts:
15V: 15V GND -15V; MKDS3/3_5,08
C13, C14, C17, C18, C27, C28, C29, C30, C31, C32: 100nF; C0805
C23: 33nF; C0805
C24: 10nF; C0805
C35, C40: 220pF; C0805
C36, C39: 100µF; E2,5-6
IC2, IC3, IC4: TL072D; SO08
POT_L_OPT: JMP3
POT_R_OPT: JMP3
R1, R22: 22k; M0805
R14, R23: 12k; M0805
R18, R19, R20, R21, R24, R25: R-EU_M0805; M0805
R34: 75k; M0805
R35: 150k; M0805
TP2, TP3, TP9, TP10: TPB2,54; B2,54

Connections:
+15V: 15V.P$1, C27.1, C28.1, C29.1, C35.1, C36.+, IC2.8 (V+), IC3.8 (V+), IC4.8 (V+); also elsewhere on the board
-15V: 15V.P$3, C30.2, C31.2, C32.2, C39.-, C40.2, IC2.4 (V-), IC3.4 (V-), IC4.4 (V-); also elsewhere on the board
GND: 15V.P$2, C24.2, C27.2, C28.2, C29.2, C30.1, C31.1, C32.1, C35.2, C36.-, C39.+, C40.1, IC2.5 (+IN), IC3.5 (+IN), POT_L_OPT.3, POT_R_OPT.3, R1.1, R22.1; also elsewhere on the board
L2: R24.2; also elsewhere on the board
L7: IC3.7 (OUT), R25.1; also elsewhere on the board
L_IN: C13.1; also elsewhere on the board
L_OUT: POT_L_OPT.2; also elsewhere on the board
MIC_IN: R20.2, R21.2; also elsewhere on the board
unnamed: IC3.6 (-IN), R21.1, R24.1, R25.2, TP3.TP
unnamed: IC2.6 (-IN), R18.2, R19.1, R20.1, TP2.TP
unnamed: IC2.1 (OUT), IC2.2 (-IN), POT_R_OPT.1, R14.2, TP10.TP
unnamed: C14.2, IC2.3 (+IN), R1.2
unnamed: C13.2, C14.1, R14.1
unnamed: IC3.1 (OUT), IC3.2 (-IN), POT_L_OPT.1, R23.2, TP9.TP
unnamed: C18.2, IC3.3 (+IN), R22.2
unnamed: C17.2, C18.1, R23.1
unnamed: C24.1, IC4.5 (+IN), R35.2
unnamed: C23.2, R34.1, R35.1
R2: R19.2; also elsewhere on the board
R7: IC2.7 (OUT), R18.1; also elsewhere on the board
R_IN: C17.1; also elsewhere on the board
R_OUT: POT_R_OPT.2; also elsewhere on the board
SUB_IN: R34.2; also elsewhere on the board
SUB_PHASE: C23.1, IC4.6 (-IN), IC4.7 (OUT); also elsewhere on the board

Notes on the sheet:
Sallen-Key HP 2. Ordnung Butterworth fg = 100Hz
Sallen-Key TP 2. Ordnung Tschebyscheff 0.5 dB fg = 100Hz

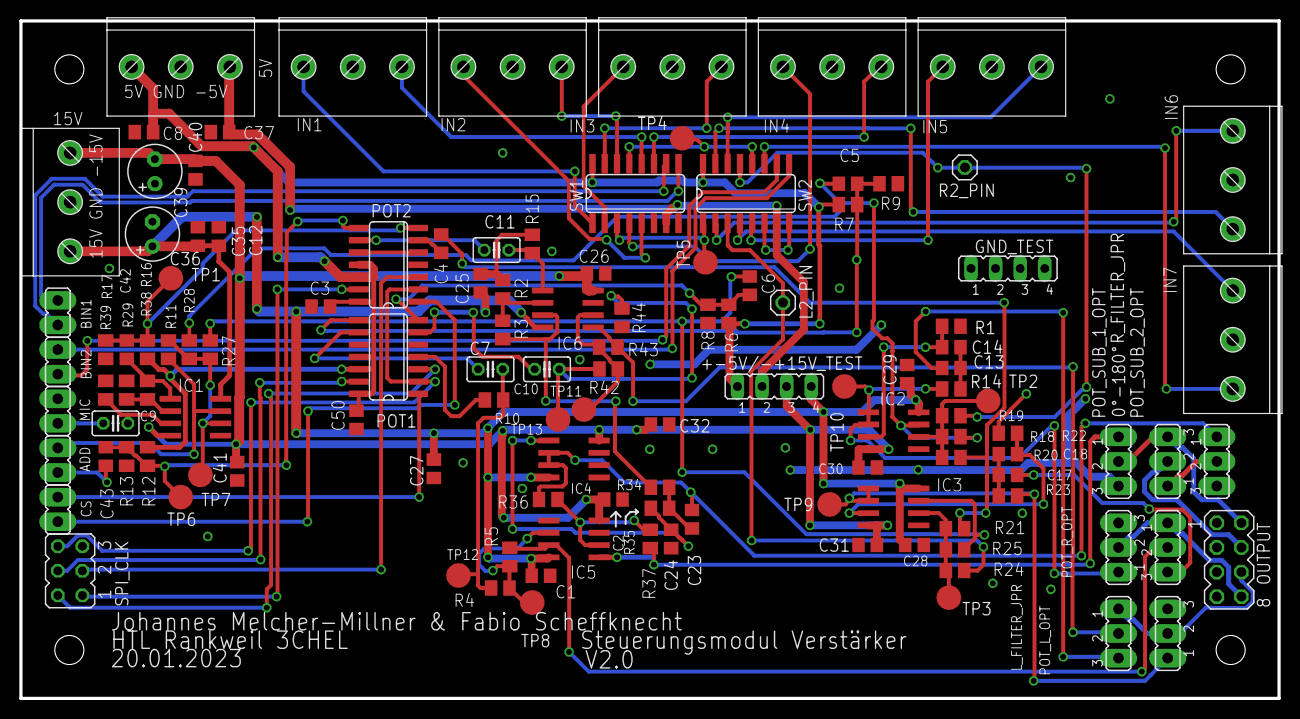
[picture p18: board Steuerungsmodul.brd from above]

Board: 2 copper layers, 130.0 x 70.0 mm, 123 parts (0 on the bottom side), 81 nets.

Other parts of the board:
U$1: HTL-A4-H
