TechanisYT/innoweek_amp/Aktivfilter/alt.brd

## EAGLE design Aktivfilter/alt.brd (2023-11-27)

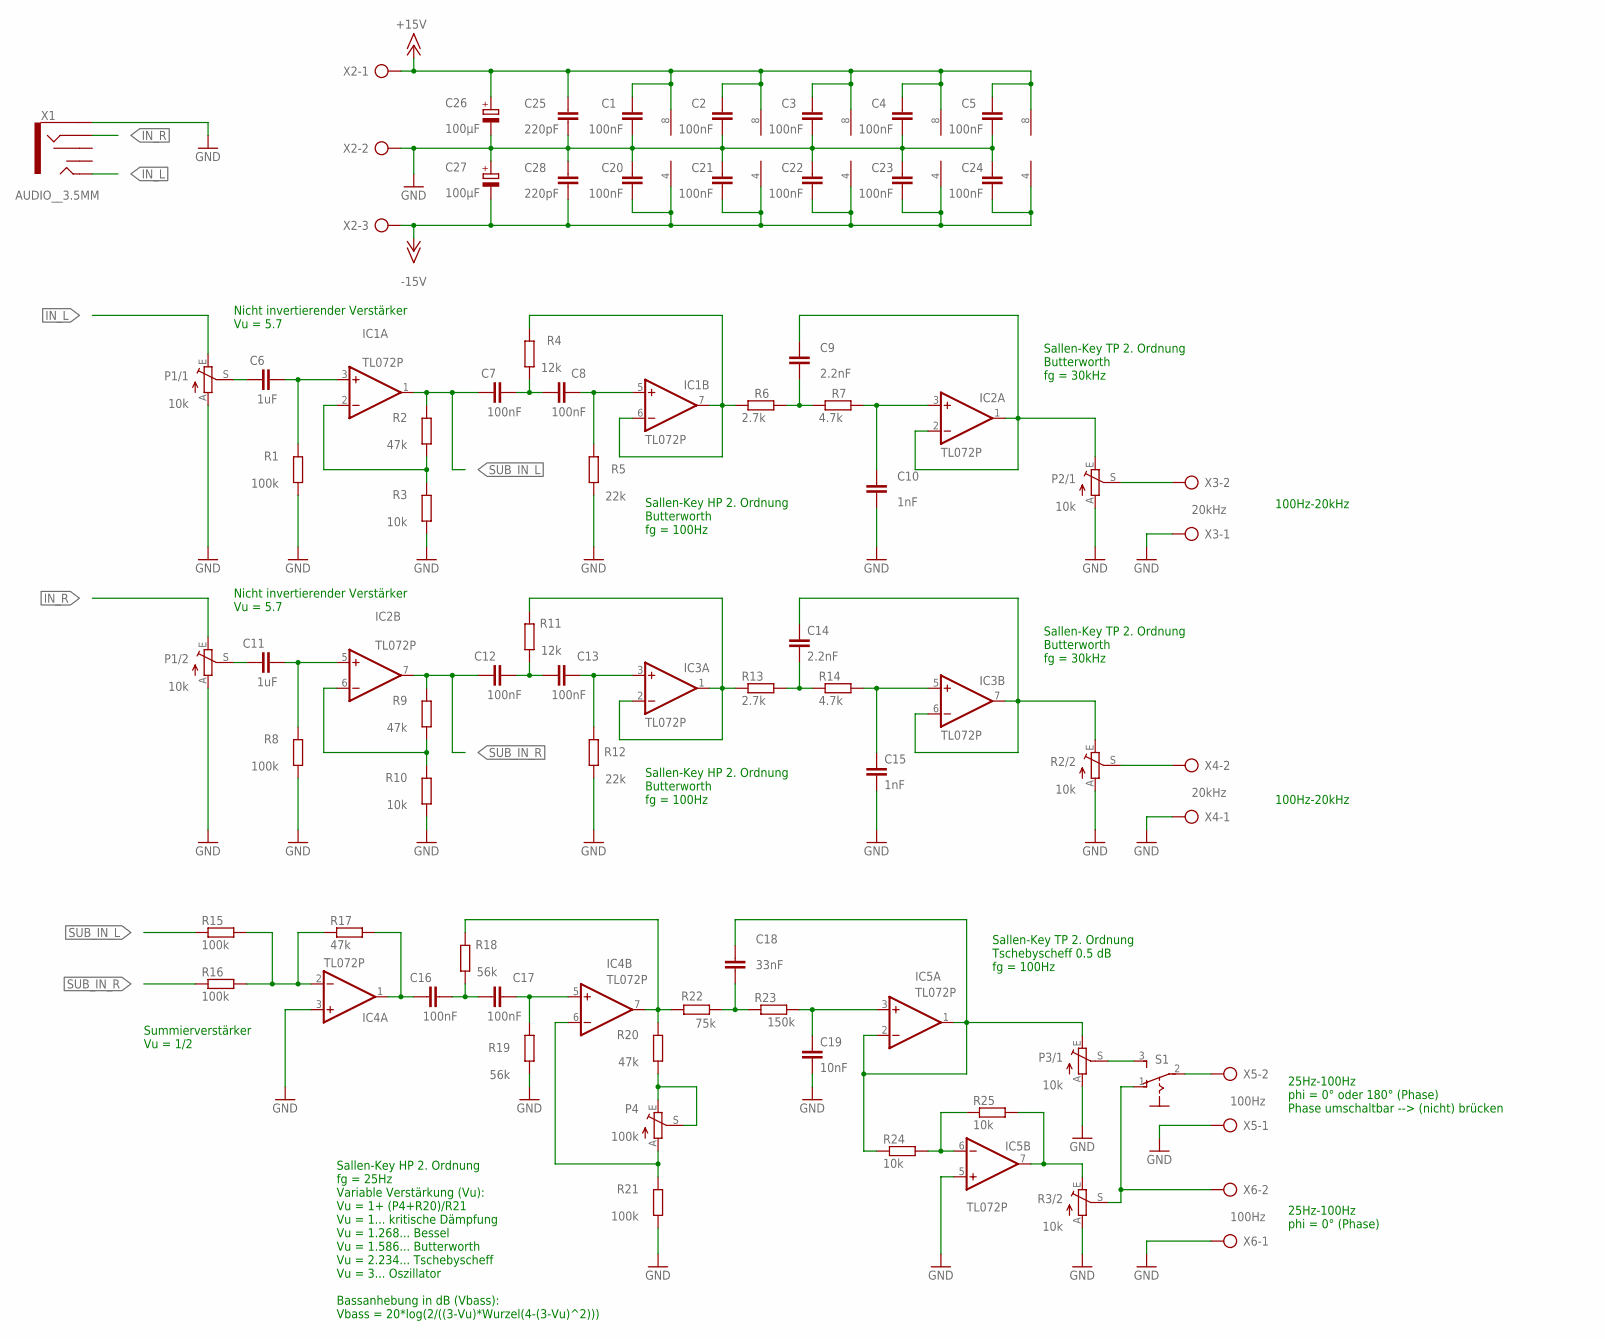
[picture p19: schematic alt.sch]

Parts:
C1, C2, C3, C4, C5, C7, C8, C12, C13, C17, C20, C21, C22, C23, C24: 100nF; C025-025X050
C6, C11: 1uF; C025-025X050
C9, C14: 2.2nF; C025-025X050
C10, C15: 1nF; C025-025X050
C16: 100nF; C050-025X075
C18: 33nF; C025-025X050
C19: 10nF; C025-025X050
C25, C28: 220pF; C025-025X050
C26, C27: 100µF; E2,5-6
IC1, IC2, IC3, IC4, IC5: TL072P; DIL08
P1/1, P1/2, P2/1, P3/1: 10k; B64Y
P4: 100k; B64Y
R1, R15, R16, R21: 100k; 0207/10
R2, R17, R20: 47k; 0207/10
R2/2, R3/2: 10k; B64Y
R3, R10, R24, R25: 10k; 0207/10
R4, R11: 12k; 0207/10
R5, R12: 22k; 0207/10
R6, R13: 2.7k; 0207/10
R7, R14: 4.7k; 0207/10
R8: 100k; 0207/7
R9: 47k; 0207/7
R18: 56k; 0207/10
R19: 56k; 0207/7
R22: 75k; 0207/7
R23: 150k; 0207/10
S1: 255SB
X1: AUDIO__3.5MM; AUDIO-JACK
X2: AK300/3
X3, X4: 20kHz; AK300/2
X5, X6: 100Hz; AK300/2

Connections:
+15V: C1.1, C2.1, C3.1, C4.1, C5.1, C25.1, C26.+, IC1.8 (V+), IC2.8 (V+), IC3.8 (V+), IC4.8 (V+), IC5.8 (V+), X2.1
-15V: C20.2, C21.2, C22.2, C23.2, C24.2, C27.-, C28.2, IC1.4 (V-), IC2.4 (V-), IC3.4 (V-), IC4.4 (V-), IC5.4 (V-), X2.3
GND: C1.2, C2.2, C3.2, C4.2, C5.2, C10.2, C15.2, C19.2, C20.1, C21.1, C22.1, C23.1, C24.1, C25.2, C26.-, C27.+, C28.1, IC4.3 (+IN), IC5.5 (+IN), P1/1.A, P1/2.A, P2/1.A, P3/1.A, R1.1, R2/2.A, R3.1, R3/2.A, R5.1, R8.1, R10.1, R12.1, R19.1, R21.1, X1.SLEEVE, X2.2, X3.1, X4.1, X5.1, X6.1
IN_L: P1/1.E, X1.TIP
IN_R: P1/2.E, X1.RING
unnamed: P3/1.S, S1.3 (S)
unnamed: R3/2.S, S1.1 (O), X6.2
unnamed: S1.2, X5.2
unnamed: C6.1, P1/1.S
unnamed: C6.2, IC1.3 (+IN), R1.2
unnamed: IC1.2 (-IN), R2.1, R3.2
unnamed: IC1.6 (-IN), IC1.7 (OUT), R4.2, R6.1
unnamed: C8.2, IC1.5 (+IN), R5.2
unnamed: C7.2, C8.1, R4.1
unnamed: IC4.2 (-IN), R15.2, R16.2, R17.1
unnamed: C9.2, R6.2, R7.1
unnamed: C10.1, IC2.3 (+IN), R7.2
unnamed: C9.1, IC2.1 (OUT), IC2.2 (-IN), P2/1.E
unnamed: C16.1, IC4.1 (OUT), R17.2
unnamed: C11.1, P1/2.S
unnamed: C11.2, IC2.5 (+IN), R8.2
unnamed: IC2.6 (-IN), R9.1, R10.2
unnamed: IC3.1 (OUT), IC3.2 (-IN), R11.2, R13.1
unnamed: C13.2, IC3.3 (+IN), R12.2
unnamed: C12.2, C13.1, R11.1
unnamed: C14.2, R13.2, R14.1
unnamed: C15.1, IC3.5 (+IN), R14.2
unnamed: C14.1, IC3.6 (-IN), IC3.7 (OUT), R2/2.E
unnamed: C16.2, C17.1, R18.1
unnamed: C17.2, IC4.5 (+IN), R19.2
unnamed: IC4.7 (OUT), R18.2, R20.2, R22.2
unnamed: IC4.6 (-IN), P4.A, R21.2
unnamed: IC5.6 (-IN), R24.2, R25.1
unnamed: P4.E, P4.S, R20.1
unnamed: C19.1, IC5.3 (+IN), R23.2
unnamed: C18.2, R22.1, R23.1
OUT_L: P2/1.S, X3.2
OUT_R: R2/2.S, X4.2
SUB_IN_L: C7.1, IC1.1 (OUT), R2.2, R15.1
SUB_IN_R: C12.1, IC2.7 (OUT), R9.2, R16.1
SUB_OUT: IC5.7 (OUT), R3/2.E, R25.2
SUB_OUT-180: C18.1, IC5.1 (OUT), IC5.2 (-IN), P3/1.E, R24.1

Notes on the sheet:
100Hz-20kHz
25Hz-100Hz phi = 0° oder 180° (Phase) Phase umschaltbar --> (nicht) brücken
25Hz-100Hz phi = 0° (Phase)
Sallen-Key TP 2. Ordnung Butterworth fg = 30kHz
Sallen-Key HP 2. Ordnung Butterworth fg = 100Hz
Nicht invertierender Verstärker Vu = 5.7
Summierverstärker Vu = 1/2
Sallen-Key TP 2. Ordnung Tschebyscheff 0.5 dB fg = 100Hz
Sallen-Key HP 2. Ordnung fg = 25Hz Variable Verstärkung (Vu): Vu = 1+ (P4+R20)/R21 Vu = 1... kritische Dämpfung Vu = 1.268... Bessel Vu = 1.586... Butterworth Vu = 2.234... Tschebyscheff Vu = 3... Oszillator Bassanhebung in dB (Vbass): Vbass = 20*log(2/((3-Vu)*Wurzel(4-(3-Vu)^2)))

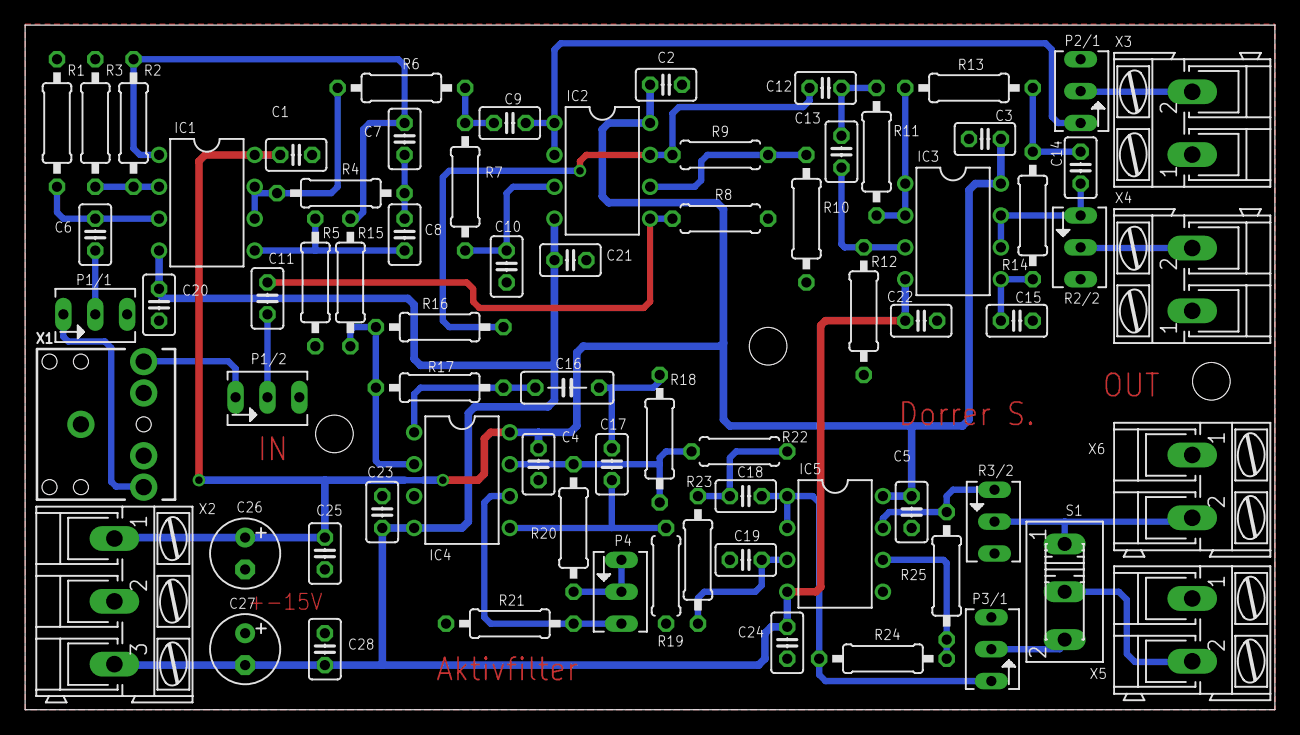
[picture p20: board alt.brd from above]

Board: 2 copper layers, 99.5 x 54.5 mm, 72 parts (0 on the bottom side), 42 nets.
